shaurjyabanerjee/seamonster/prototyping_pics/panel_wiring_6.jpg

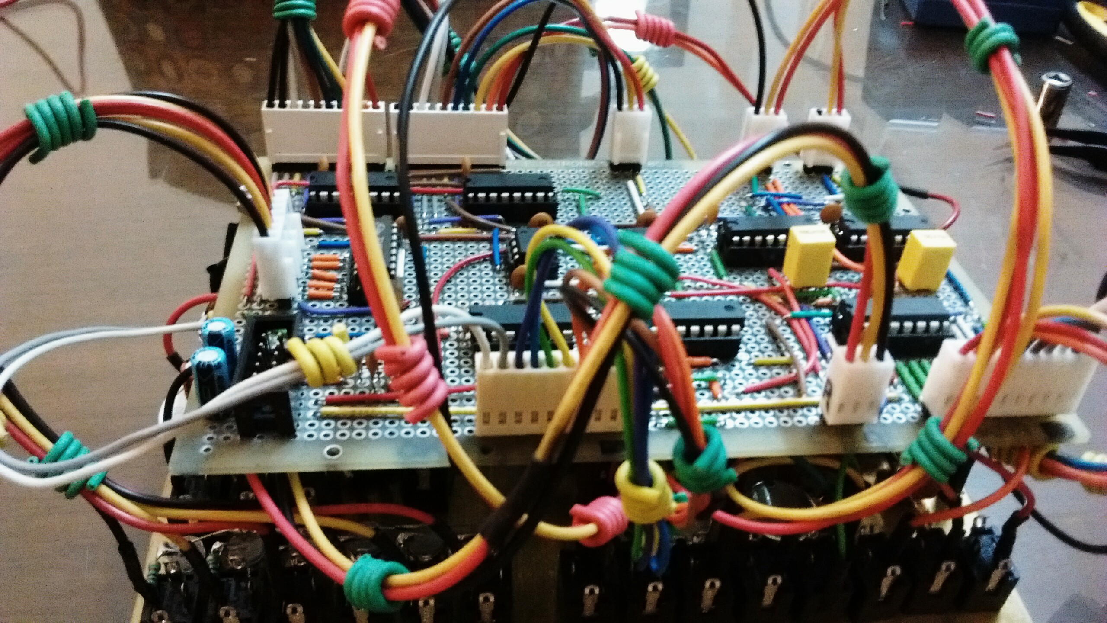
prototyping_pics/panel_wiring_6.jpg
