shaurjyabanerjee/seamonster/prototyping_pics/panel_wiring_5.jpg

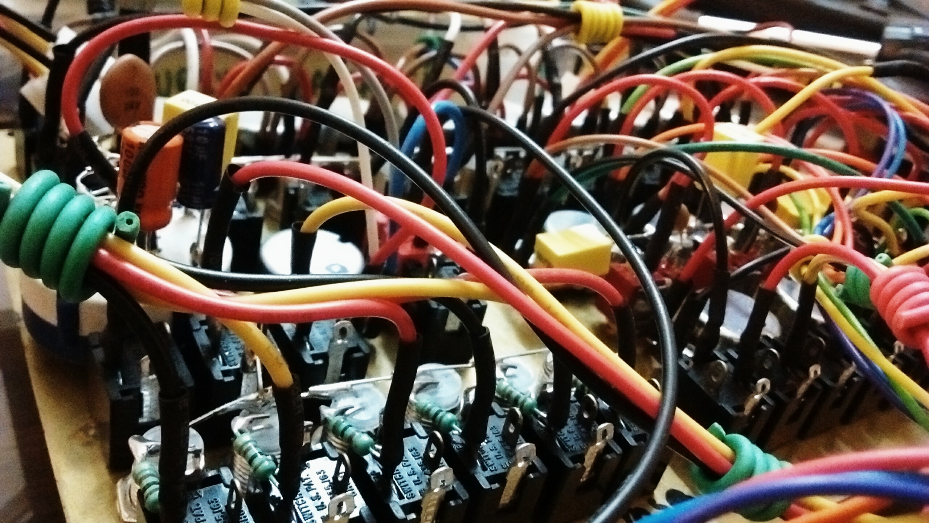
prototyping_pics/panel_wiring_5.jpg
