shaurjyabanerjee/seamonster/pcb_layouts/seamonster_revision_notes.rtf

SeaMonster PCB Revision Notes

• Apply buffering to the output stage of all fixed frequency oscillators
• Add buffering to DG408 MUX output, will allow multing
• Add offset resistors in series to R2 for VCOs
• Add buffering to complex XOR outs
• Make negative voltage clamping circuit for external clock input
• Maybe use left over inverter from 40106 to ‘clean’ external clock
•
