shaurjyabanerjee/seamonster/prototyping_pics/finished_seamonster_1.jpg

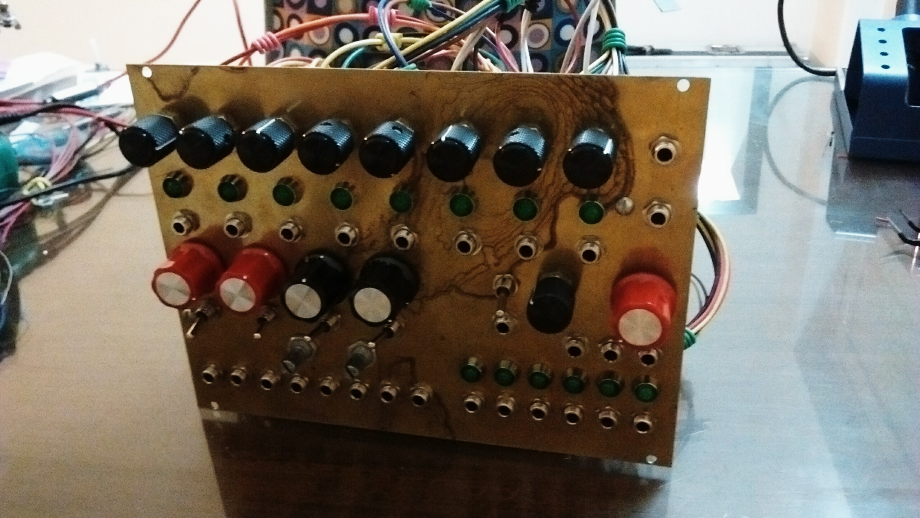
prototyping_pics/finished_seamonster_1.jpg
