shaurjyabanerjee/seamonster/prototyping_pics/finished_seamonster_2.jpg

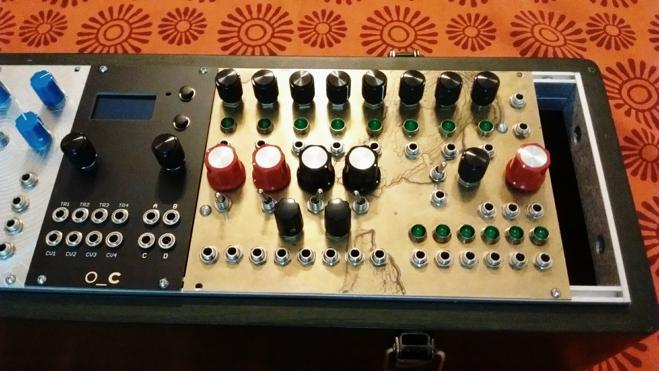
prototyping_pics/finished_seamonster_2.jpg
