shaurjyabanerjee/seamonster/prototyping_pics/finished_seamonster_3.jpg

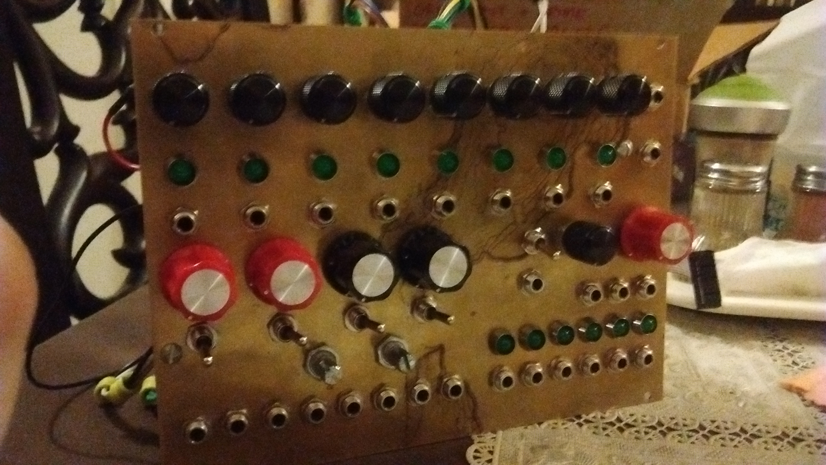
prototyping_pics/finished_seamonster_3.jpg
