shaurjyabanerjee/seamonster/prototyping_pics/full_system.jpg

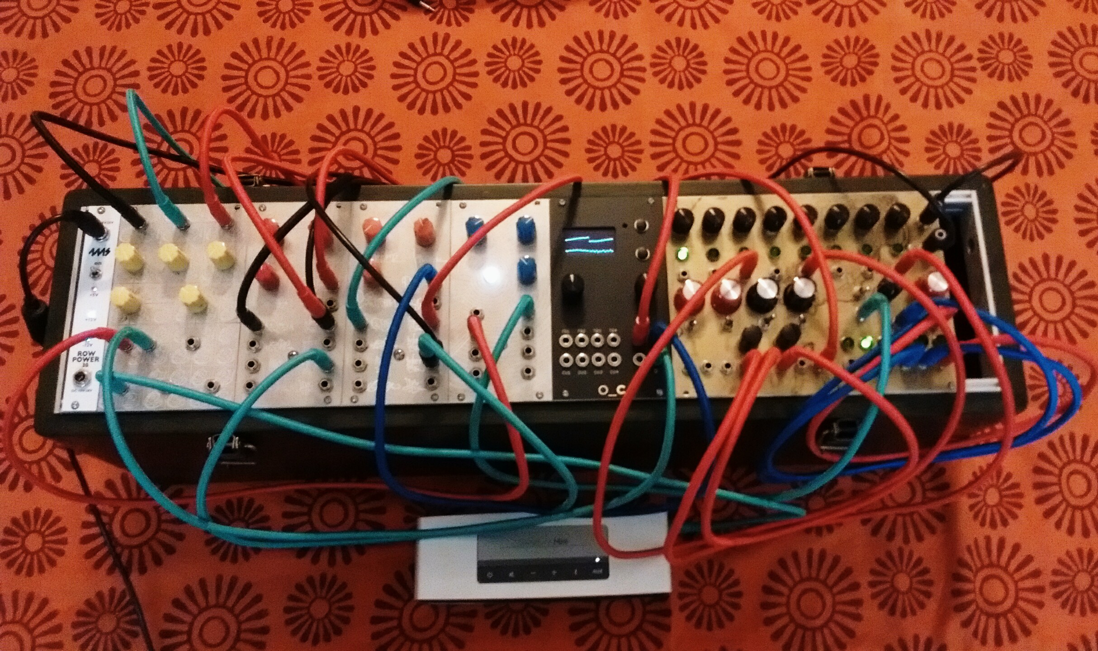
prototyping_pics/full_system.jpg
