shaurjyabanerjee/seamonster/prototyping_pics/panel_drilled.jpg

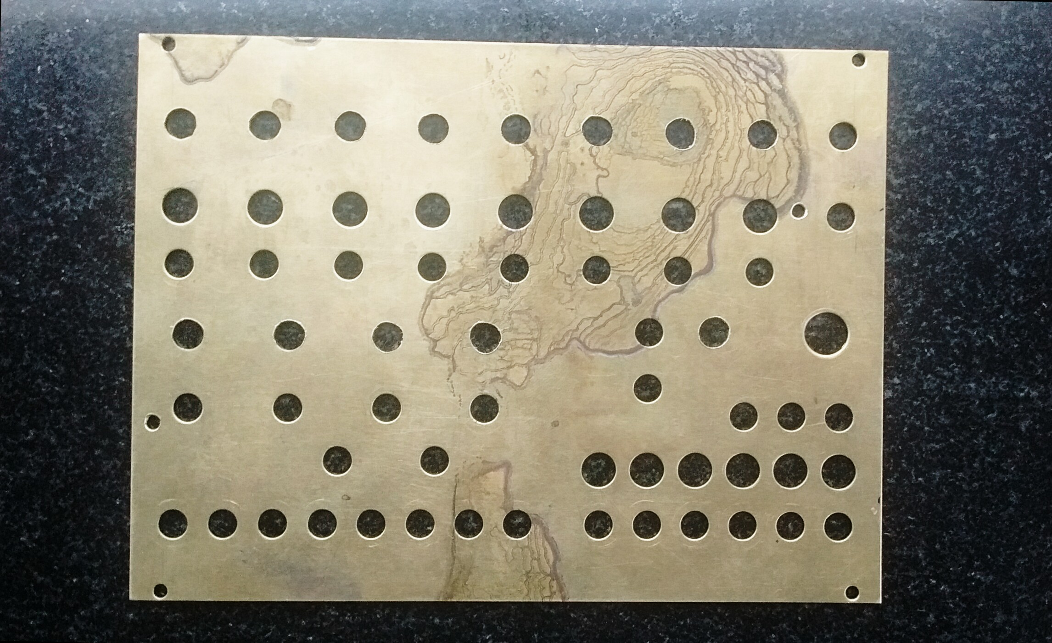
prototyping_pics/panel_drilled.jpg
