shaurjyabanerjee/seamonster/prototyping_pics/panel_fully_wired.jpg

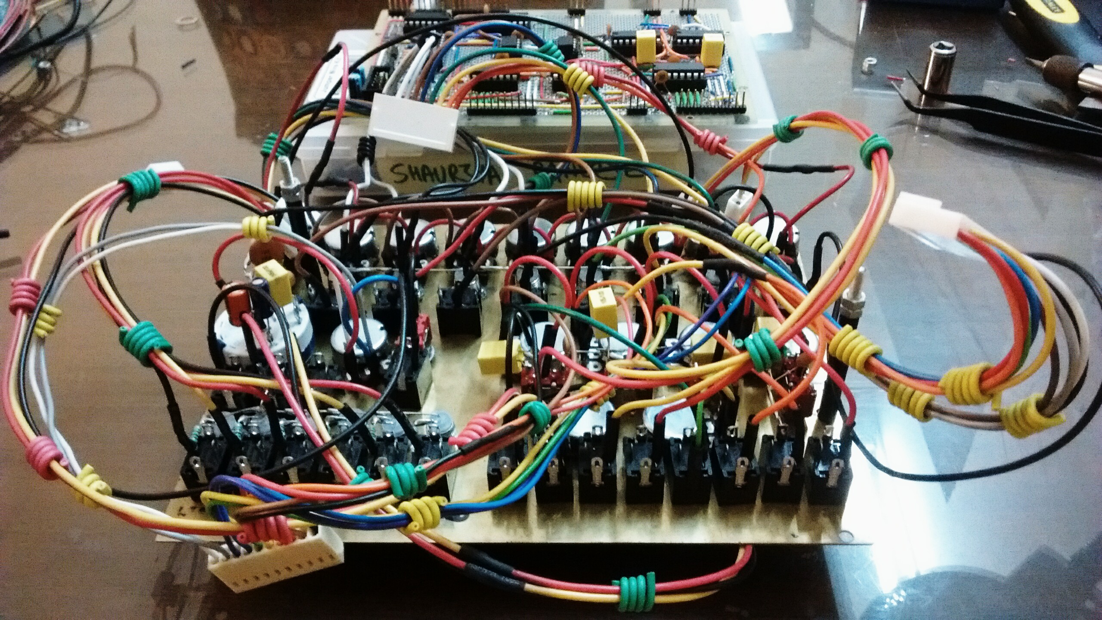
prototyping_pics/panel_fully_wired.jpg
