shaurjyabanerjee/seamonster/prototyping_pics/panel_populated_back.jpg

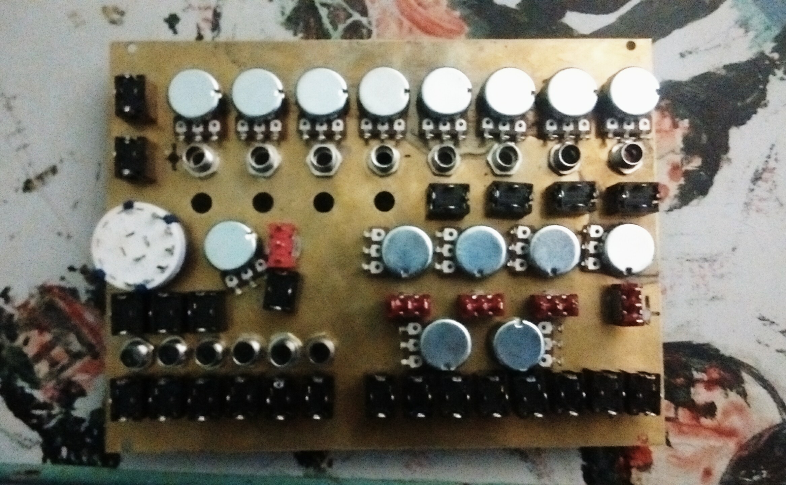
prototyping_pics/panel_populated_back.jpg
