shaurjyabanerjee/seamonster/prototyping_pics/panel_populated_front.jpg

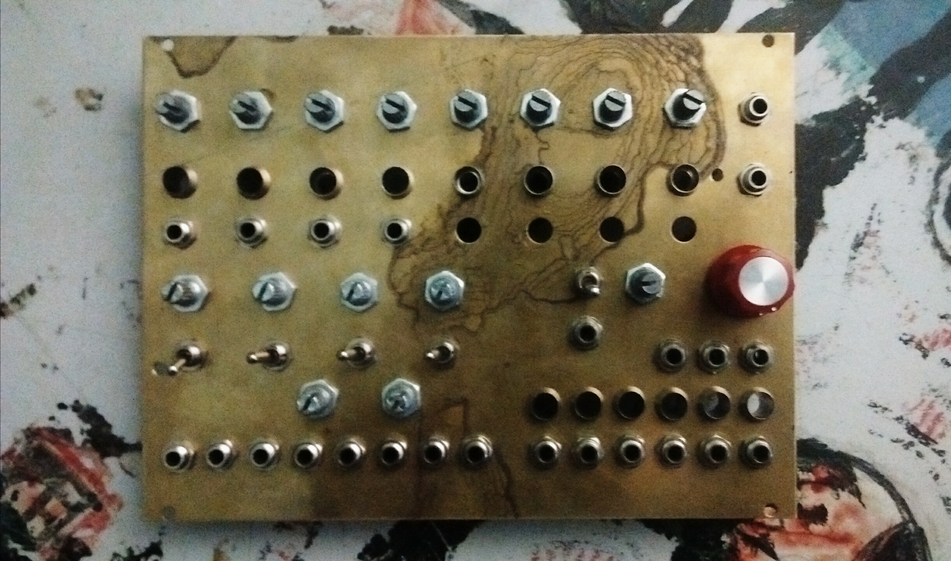
prototyping_pics/panel_populated_front.jpg
