shaurjyabanerjee/seamonster/prototyping_pics/perfboard_1.jpg

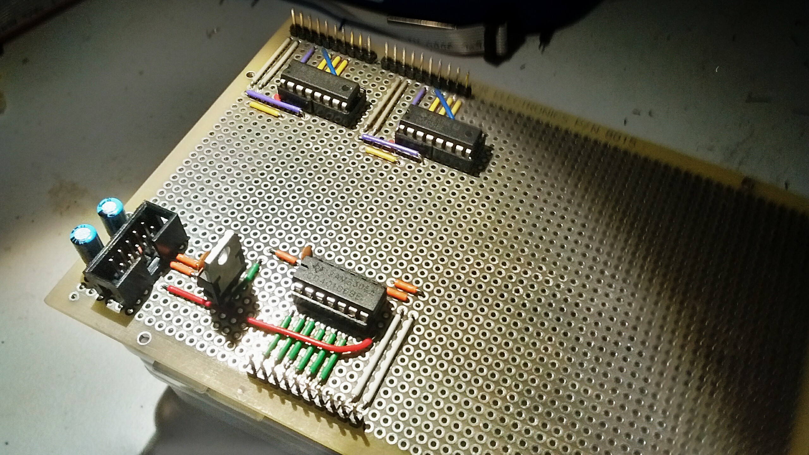
prototyping_pics/perfboard_1.jpg
