shaurjyabanerjee/seamonster/prototyping_pics/perfboard_2.jpg

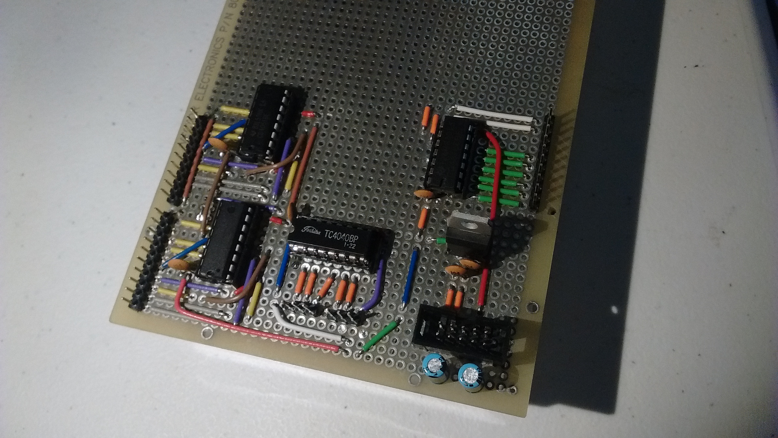
prototyping_pics/perfboard_2.jpg
