shaurjyabanerjee/seamonster/prototyping_pics/perfboard_3.jpg

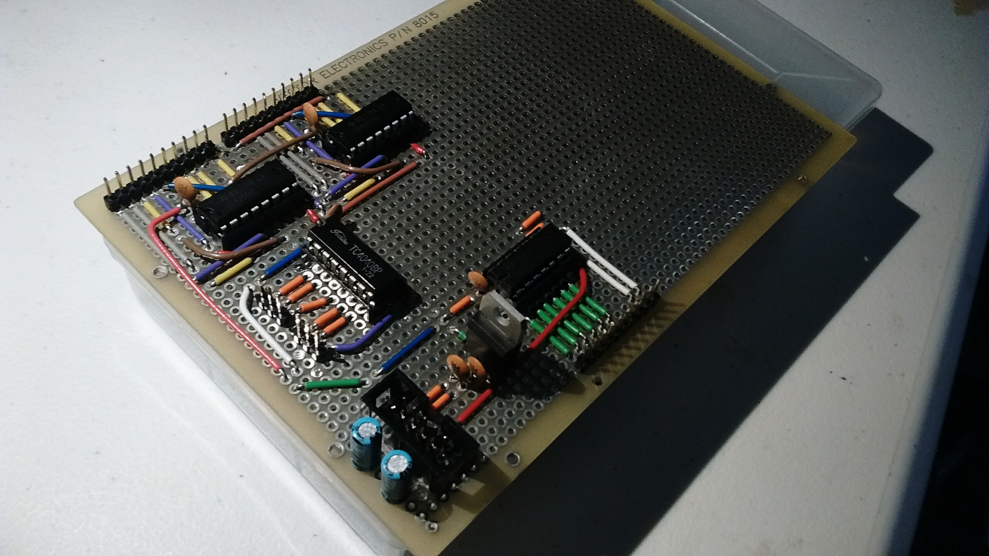
prototyping_pics/perfboard_3.jpg
