shaurjyabanerjee/seamonster/prototyping_pics/perfboard_4.jpg

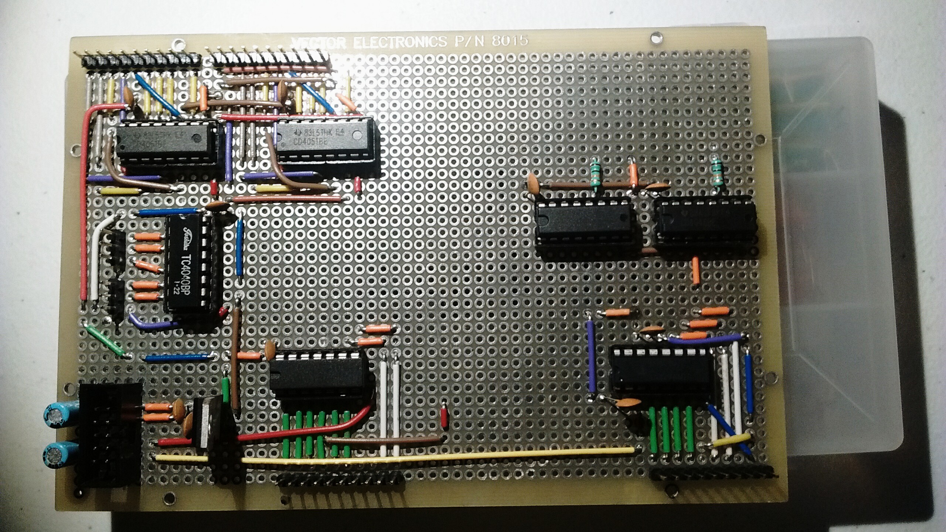
prototyping_pics/perfboard_4.jpg
