shaurjyabanerjee/seamonster/prototyping_pics/perfboard_5.jpg

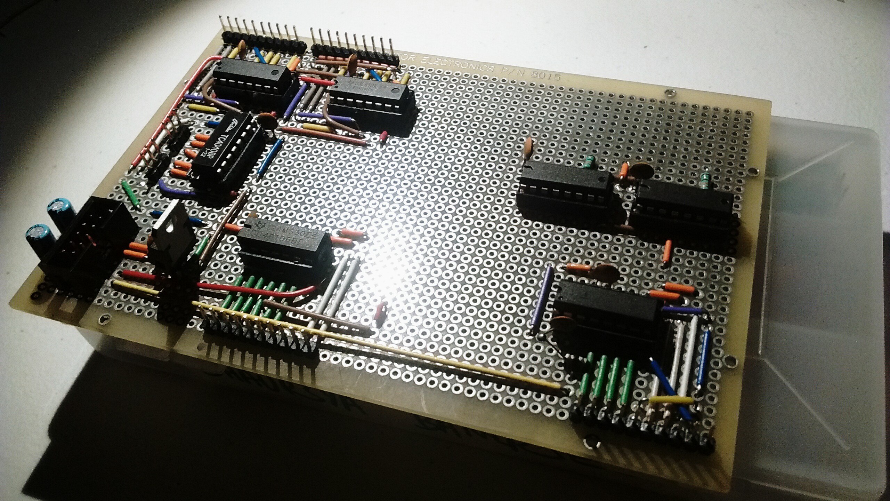
prototyping_pics/perfboard_5.jpg
