shaurjyabanerjee/seamonster/prototyping_pics/perfboard_6.jpg

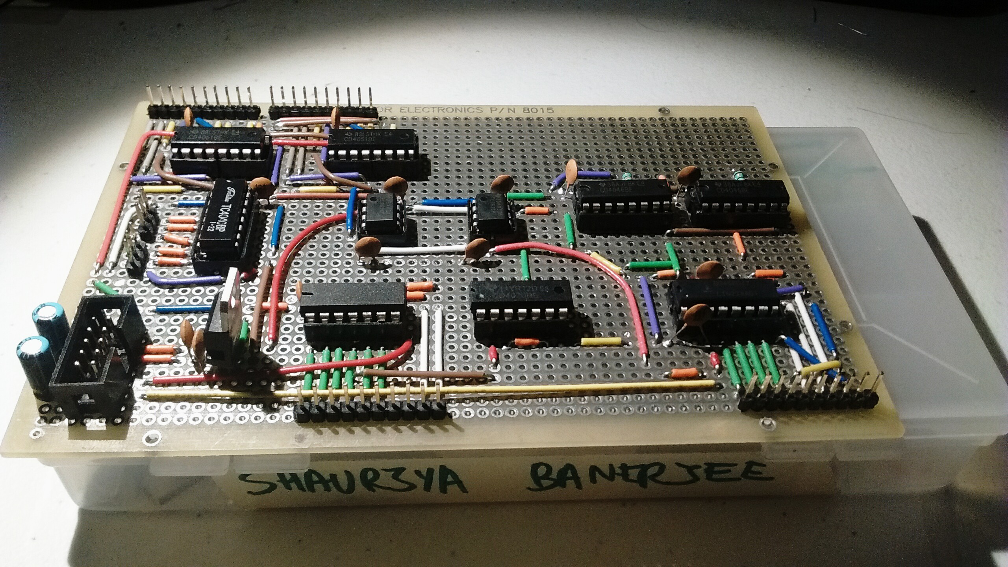
prototyping_pics/perfboard_6.jpg
