shaurjyabanerjee/seamonster/prototyping_pics/perfboard_7.jpg

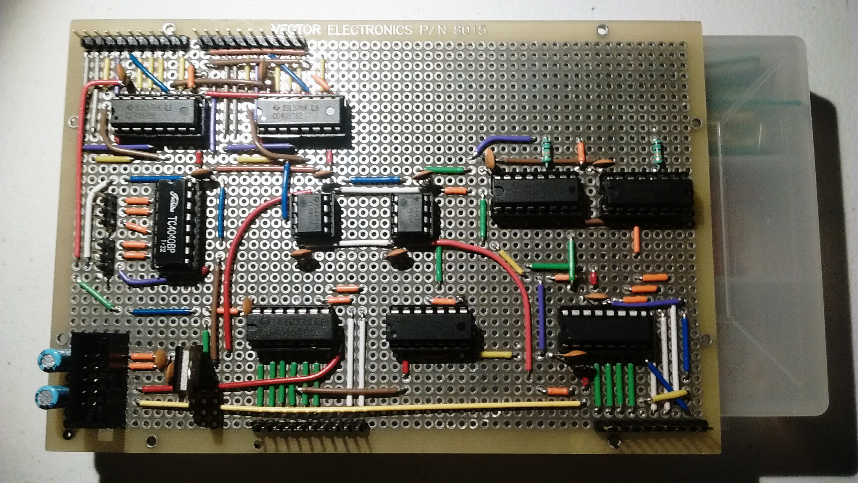
prototyping_pics/perfboard_7.jpg
