shaurjyabanerjee/seamonster/prototyping_pics/perfboard_bottom.jpg

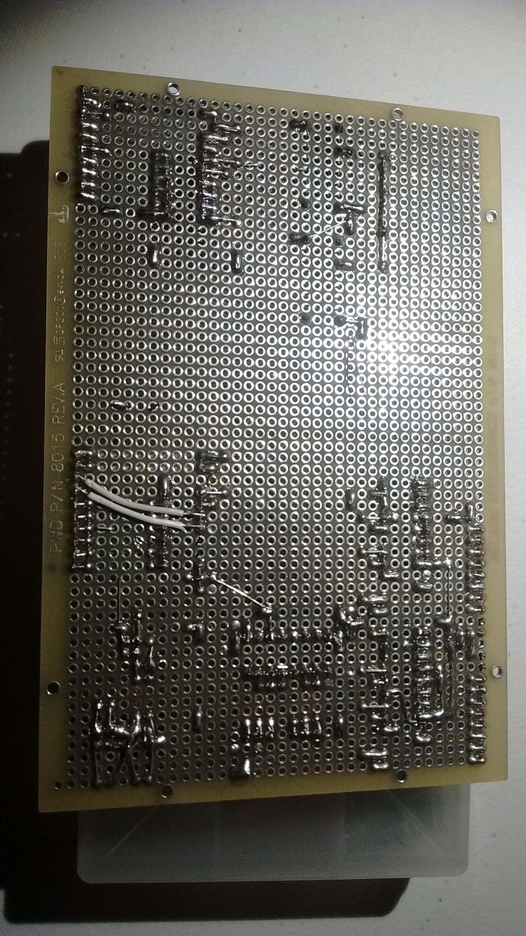
prototyping_pics/perfboard_bottom.jpg
