shaurjyabanerjee/seamonster/prototyping_pics/perfboard_finished_bottom.jpg

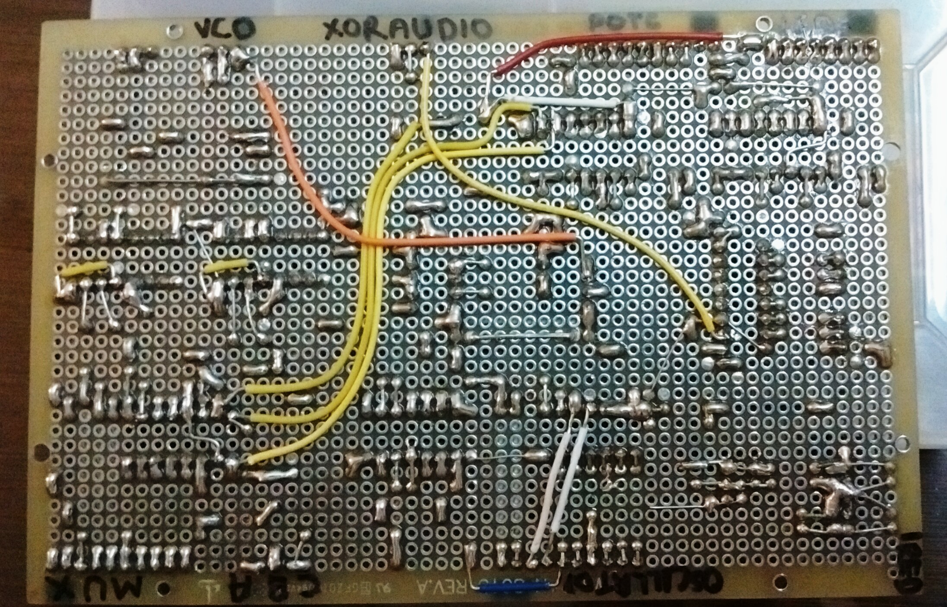
prototyping_pics/perfboard_finished_bottom.jpg
