shaurjyabanerjee/seamonster/prototyping_pics/perfboard_finished_top.jpg

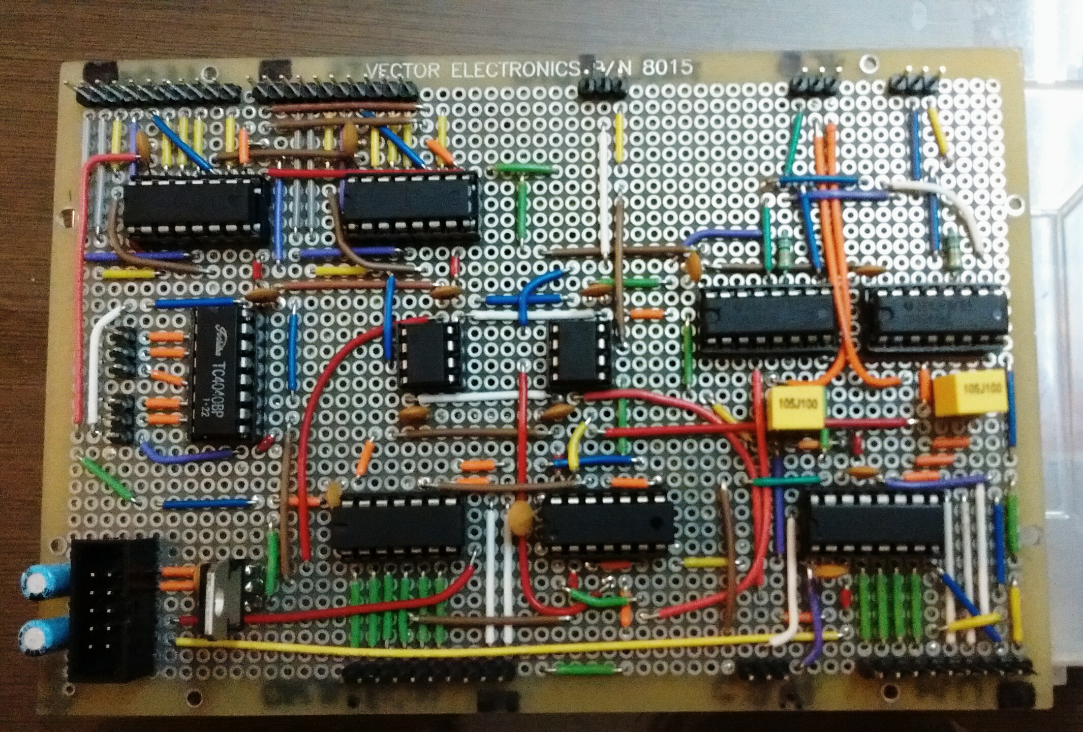
prototyping_pics/perfboard_finished_top.jpg
