shaurjyabanerjee/seamonster/pcb_layouts/panel_layouts/ai_sketches/seamonster_panel_layout/waves_simp_test1.dxf

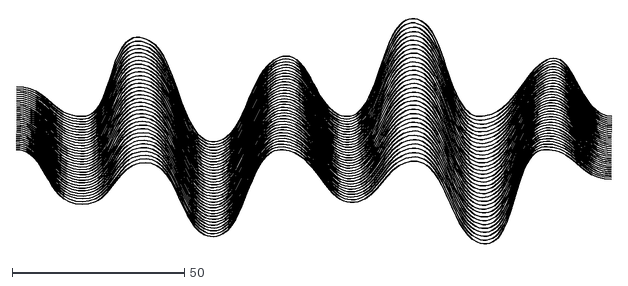
[picture p21: CAD file, 2019-03-12]
pcb_layouts/panel_layouts/ai_sketches/seamonster_panel_layout/waves_simp_test1.dxf
172.6 x 66.7
