shaurjyabanerjee/seamonster/pcb_layouts/panel_layouts/ai_sketches/wave_test1.dxf

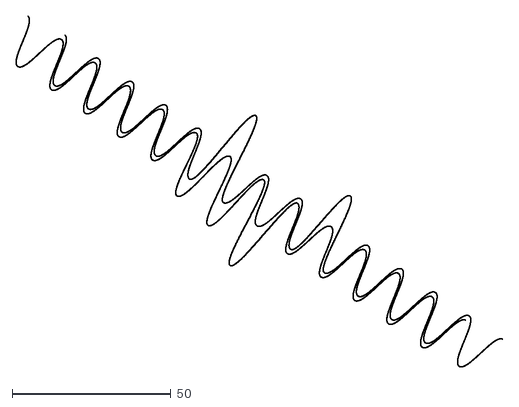
[picture p22: CAD file, 2018-10-15]
pcb_layouts/panel_layouts/ai_sketches/wave_test1.dxf
153.3 x 110.5
