shaurjyabanerjee/seamonster/pcb_layouts/panel_layouts/waves_simp_test1.dxf

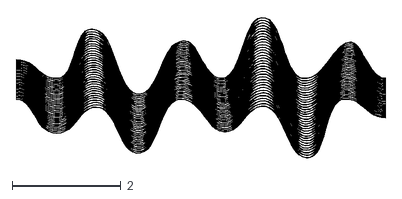
[picture p23: CAD file, 2019-03-12]
pcb_layouts/panel_layouts/waves_simp_test1.dxf
6.80 x 2.63
