shaurjyabanerjee/seamonster/pcb_layouts/panel_layouts/ai_sketches/seamonster_panel_layout/seamonster_panel_layout_2.dxf

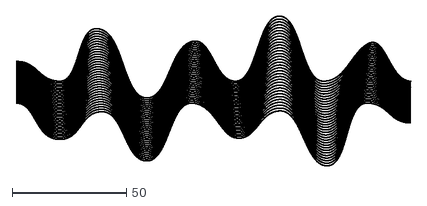
[picture p24: CAD file, 2019-03-12]
pcb_layouts/panel_layouts/ai_sketches/seamonster_panel_layout/seamonster_panel_layout_2.dxf
172.6 x 65.4
