shaurjyabanerjee/seamonster/(list of files, cad)

Other CAD files:
export_files/seamonster_drill.dxf
prototype_panel/seamonster_drill.dwg
export_files/seamonster_drill.dwg
