shaurjyabanerjee/seamonster/prototyping_pics/panel_wiring_1.jpg

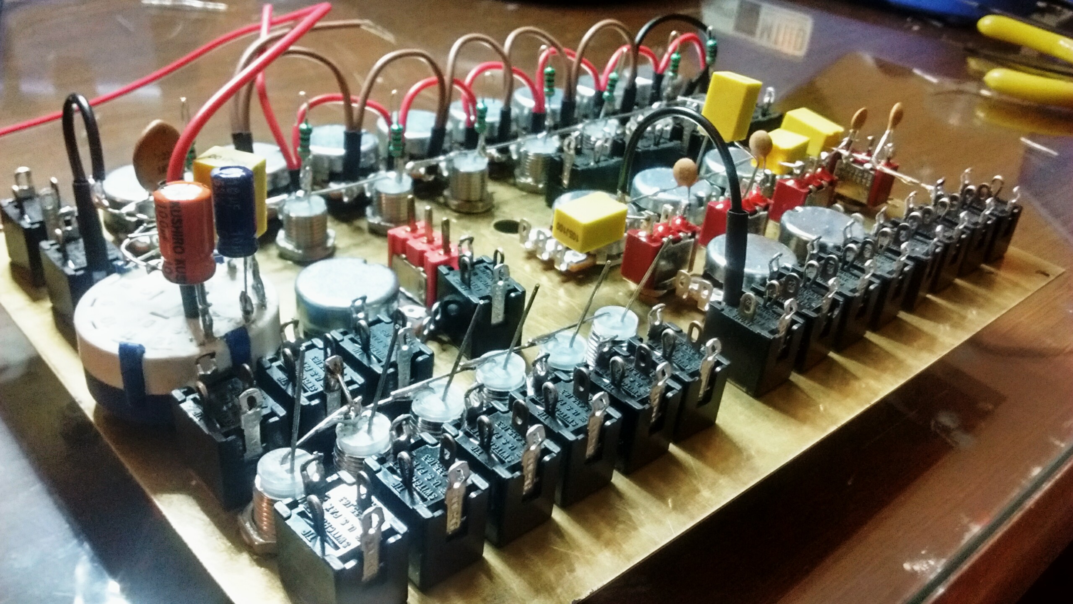
prototyping_pics/panel_wiring_1.jpg
