shaurjyabanerjee/seamonster/prototyping_pics/panel_wiring_2.jpg

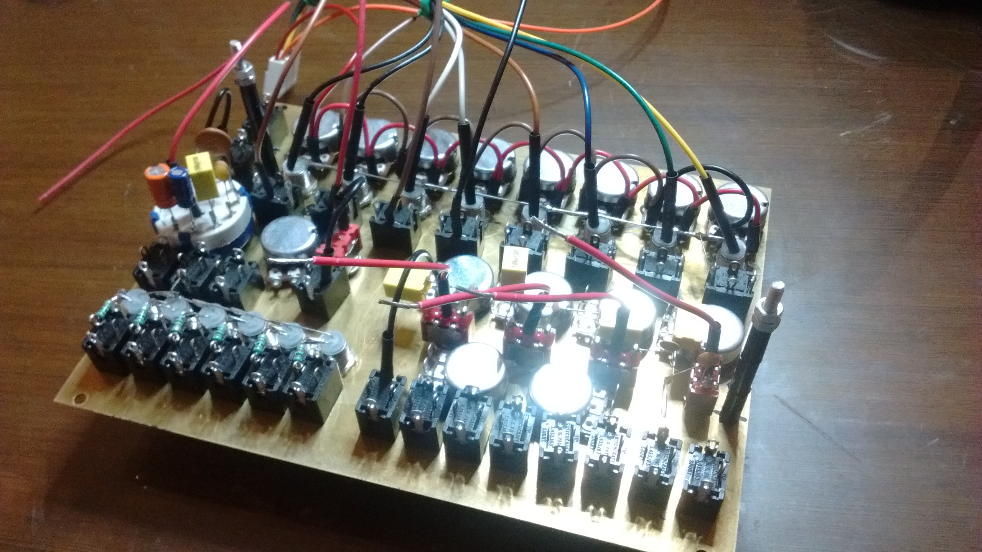
prototyping_pics/panel_wiring_2.jpg
