shaurjyabanerjee/seamonster/prototyping_pics/panel_wiring_3.jpg

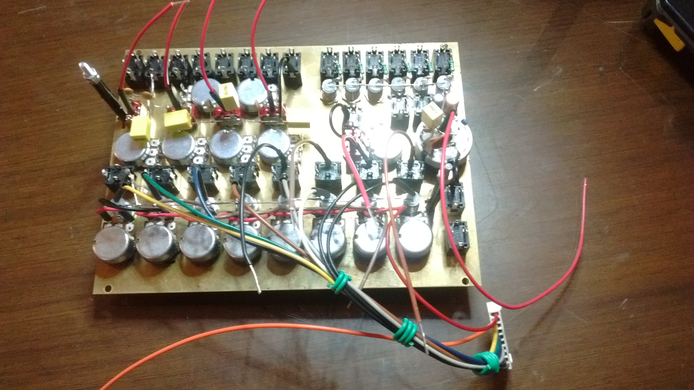
prototyping_pics/panel_wiring_3.jpg
