shaurjyabanerjee/seamonster/prototyping_pics/panel_wiring_4.jpg

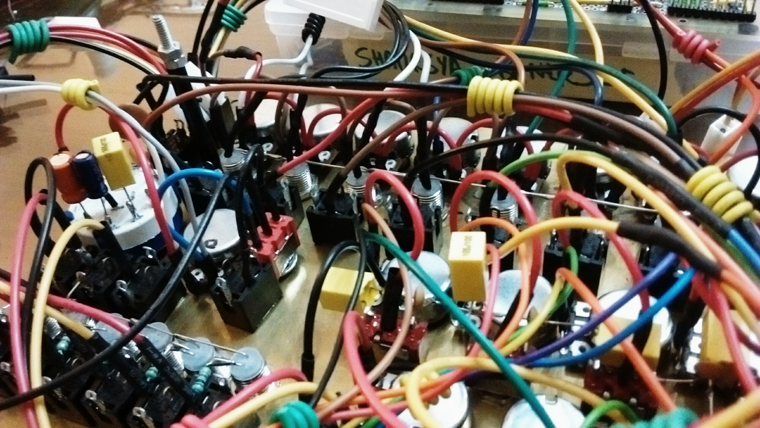
prototyping_pics/panel_wiring_4.jpg
