shaurjyabanerjee/seamonster/export_files/seamonster_drill.pdf

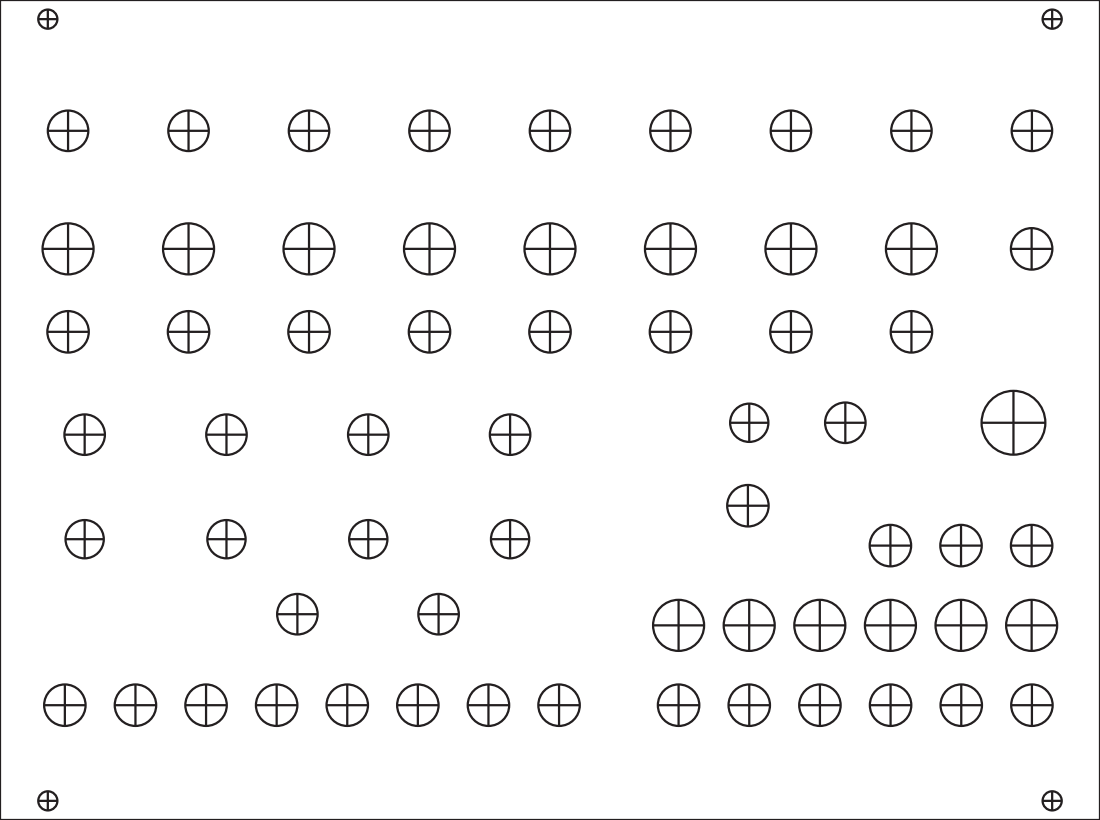
[picture p29: page 1]
