shaurjyabanerjee/seamonster/prototype_panel/seamonster_draft_1.pdf

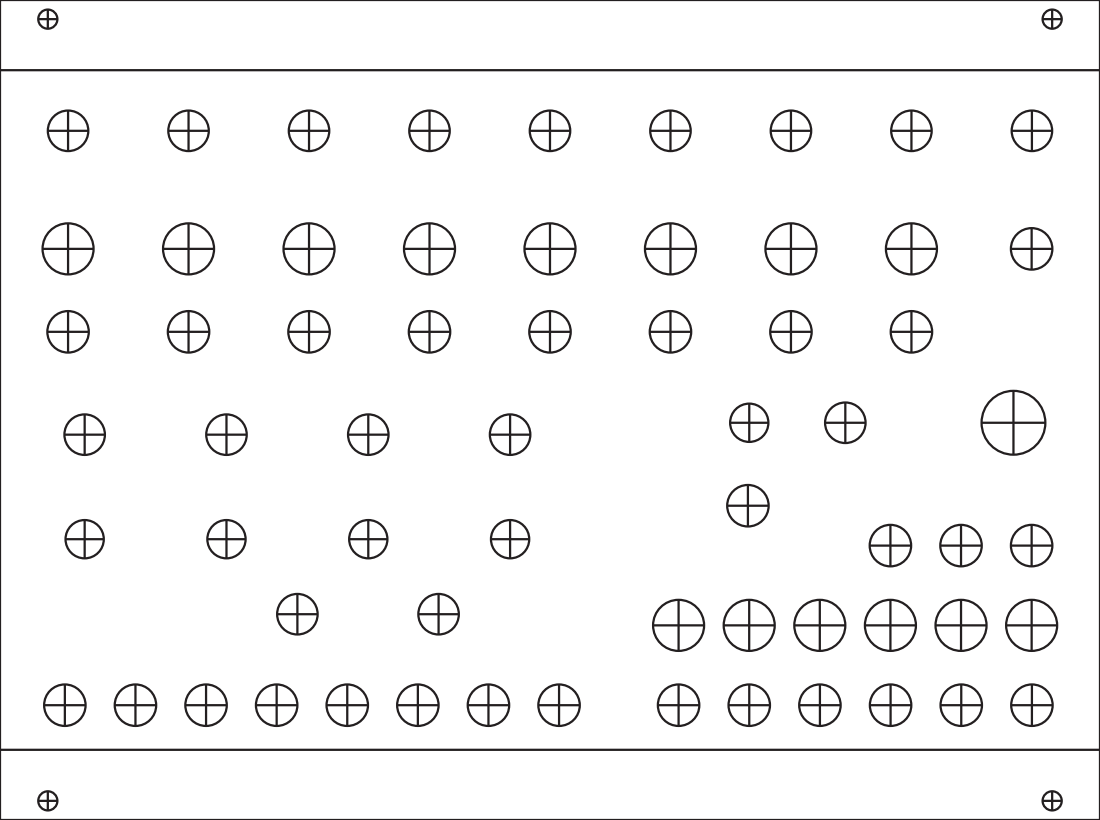
[picture p30: page 1]
