shaurjyabanerjee/seamonster/pcb_layouts/seamonster_smd/seamonster_buffered3.brd

## EAGLE design pcb_layouts/seamonster_smd/seamonster_buffered3.brd (2019-03-12)

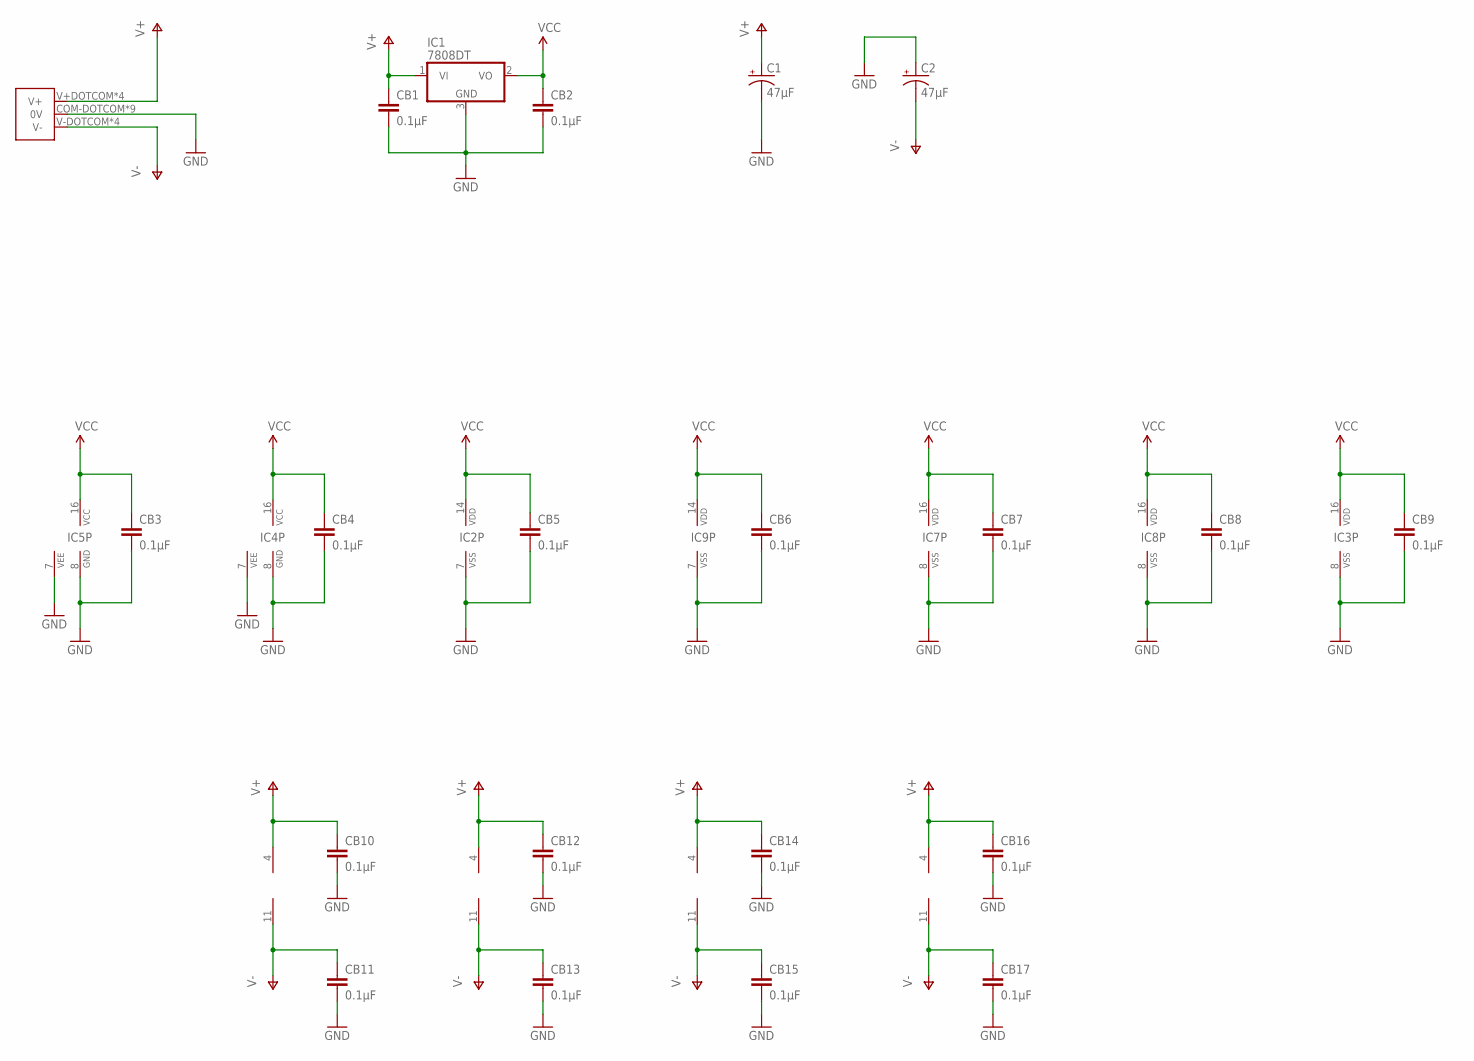
[picture p31: schematic seamonster_buffered3.sch, sheet 1, Power Filtering & Bypass]

Parts:
C1, C2: 47µF; CPOL-RADIAL-10UF-25V
CB1, CB2, CB3, CB4, CB5, CB6, CB7, CB8, CB9, CB10, CB11, CB12, CB13, CB14, CB15, CB16, CB17: 0.1µF; 0805
IC1: 7808DT; TO252
IC2: 40106D; SO14
IC3: 4040D; SO16
IC4, IC5: 4051D; SO16
IC7, IC8: 4046D; SO16
IC9: 4070D; SO14
U1, U2, U3: TL084; SO14
U4: TL084D; SO14
U$1: COMBO_POWER

Connections:
GND: C1.2 (-), C2.1 (+), CB1.2, CB2.2, CB3.2, CB4.2, CB5.2, CB6.2, CB7.2, CB8.2, CB9.2, CB10.2, CB11.2, CB12.2, CB13.2, CB14.2, CB15.2, CB16.2, CB17.2, IC1.3 (GND), IC2.7 (VSS), IC3.8 (VSS), IC4.7 (VEE), IC4.8 (GND), IC5.7 (VEE), IC5.8 (GND), IC7.8 (VSS), IC8.8 (VSS), IC9.7 (VSS), U$1.COM-DOTCOM (0V), U$1.COM-EURO1 (0V), U$1.COM-EURO2 (0V), U$1.COM-EURO3 (0V), U$1.COM-EURO4 (0V), U$1.COM-EURO5 (0V), U$1.COM-EURO6 (0V), U$1.COM-MOTM1 (0V), U$1.COM_MOTM2 (0V); also elsewhere on the board
V+: C1.1 (+), CB1.1, CB10.1, CB12.1, CB14.1, CB16.1, IC1.1 (VI), U1.4 (V+), U2.4 (V+), U3.4 (V+), U4.4 (V+), U$1.V+DOTCOM (V+), U$1.V+EURO1 (V+), U$1.V+EURO2 (V+), U$1.V+MOTM (V+); also elsewhere on the board
V-: C2.2 (-), CB11.1, CB13.1, CB15.1, CB17.1, U1.11 (V-), U2.11 (V-), U3.11 (V-), U4.11 (V-), U$1.V-DOTCOM (V-), U$1.V-EURO1 (V-), U$1.V-EURO2 (V-), U$1.V-MOTM (V-); also elsewhere on the board
VCC: CB2.1, CB3.1, CB4.1, CB5.1, CB6.1, CB7.1, CB8.1, CB9.1, IC1.2 (VO), IC2.14 (VDD), IC3.16 (VDD), IC4.16 (VCC), IC5.16 (VCC), IC7.16 (VDD), IC8.16 (VDD), IC9.14 (VDD); also elsewhere on the board

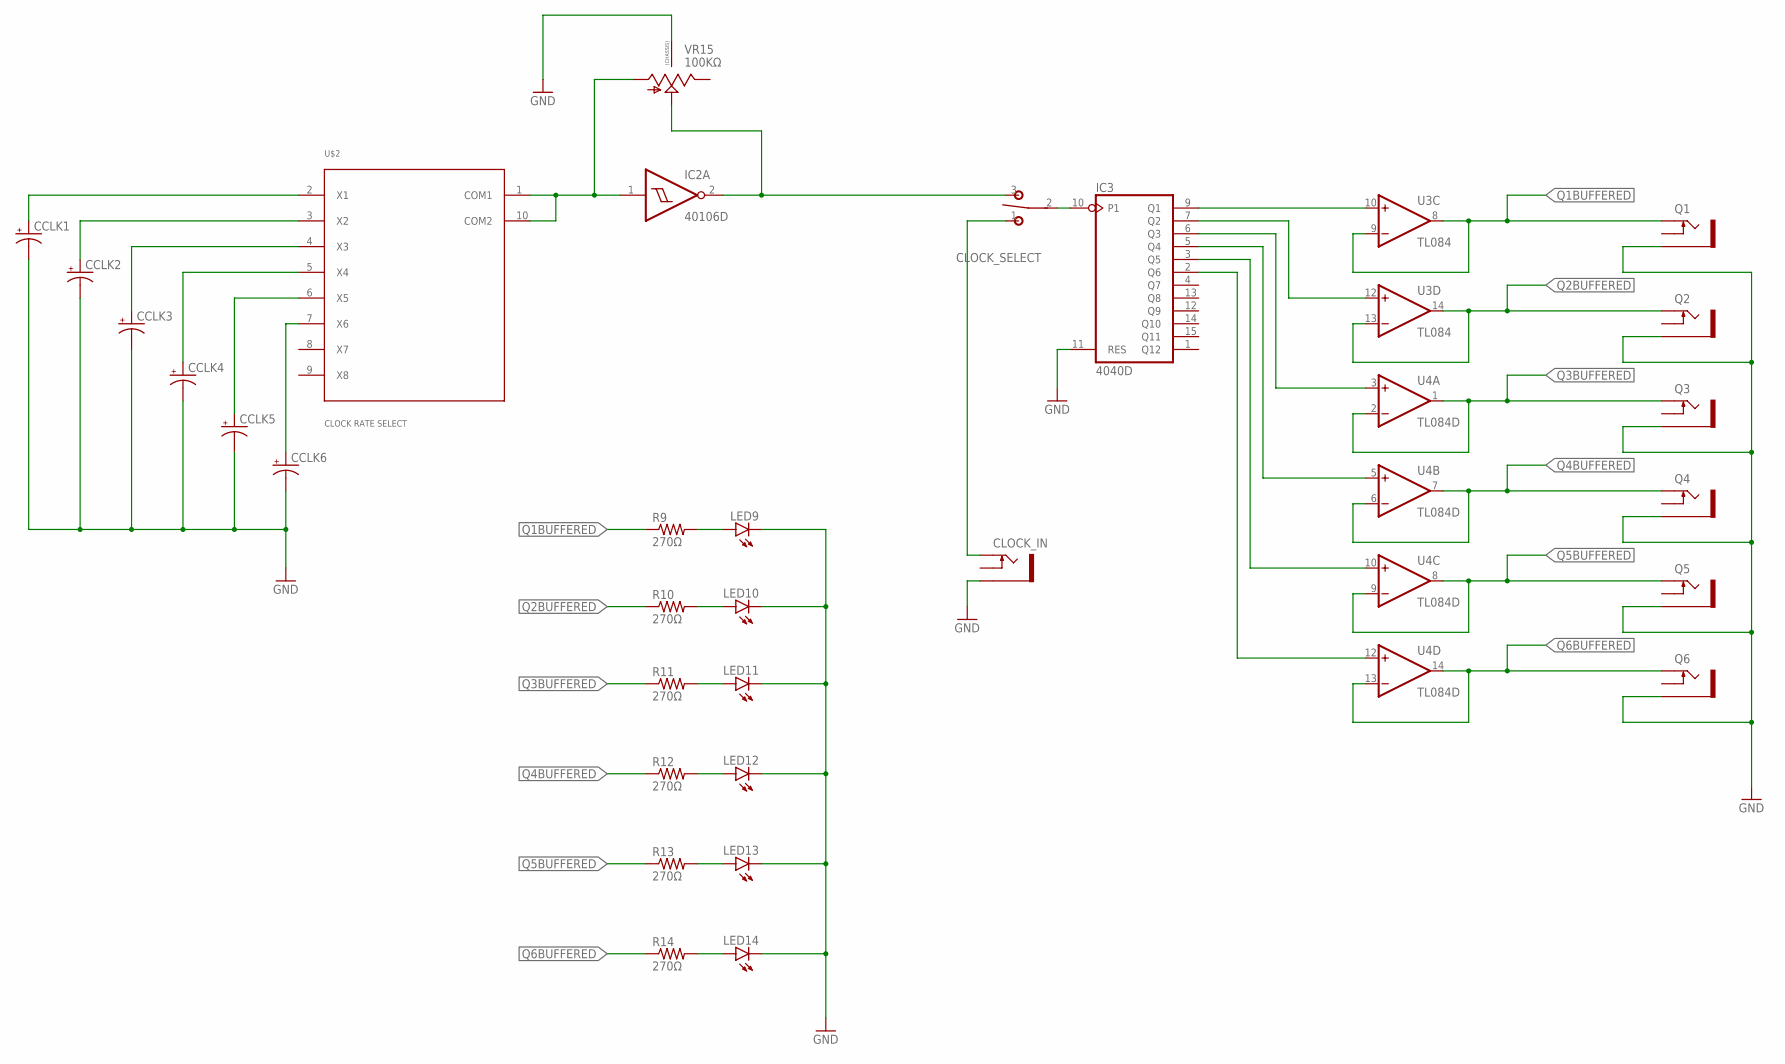
[picture p32: schematic seamonster_buffered3.sch, sheet 2, Clock Oscillator & Divider]

Parts:
CCLK1, CCLK2, CCLK3, CCLK4, CCLK5, CCLK6: 10UF-25V-20%(PTH); CPOL-RADIAL-10UF-25V
CLOCK_IN: THONKICONNNEW; WQP-PJ301M-12_JACK
CLOCK_SELECT: SPDT ON-ON; M9040P
IC2: 40106D; SO14
IC3: 4040D; SO16
LED9, LED10, LED11, LED12, LED13, LED14: LED3MM
Q1, Q2, Q3, Q4, Q5, Q6: THONKICONNNEW; WQP-PJ301M-12_JACK
R9, R10, R11, R12, R13, R14: 270Ω; 0805
U3: TL084; SO14
U4: TL084D; SO14
U$2: CLOCK RATE SELECT; ALPHA_SR1712F
VR15: 100KΩ; 9MM_SNAP-IN_POT

Connections:
GND: CCLK1.2 (-), CCLK2.2 (-), CCLK3.2 (-), CCLK4.2 (-), CCLK5.2 (-), CCLK6.2 (-), CLOCK_IN.P$3_SLEEVE (SLEEVE), IC3.11 (RES), LED9.K (C), LED10.K (C), LED11.K (C), LED12.K (C), LED13.K (C), LED14.K (C), Q1.P$3_SLEEVE (SLEEVE), Q2.P$3_SLEEVE (SLEEVE), Q3.P$3_SLEEVE (SLEEVE), Q4.P$3_SLEEVE (SLEEVE), Q5.P$3_SLEEVE (SLEEVE), Q6.P$3_SLEEVE (SLEEVE), VR15.CHASSIS2; also elsewhere on the board
unnamed: IC2.1 (I), U$2.1 (COM1), U$2.10 (COM2), VR15.1 (A)
unnamed: CCLK1.1 (+), U$2.2 (X1)
unnamed: CCLK2.1 (+), U$2.3 (X2)
unnamed: CCLK3.1 (+), U$2.4 (X3)
unnamed: CCLK4.1 (+), U$2.5 (X4)
unnamed: CCLK5.1 (+), U$2.6 (X5)
unnamed: CCLK6.1 (+), U$2.7 (X6)
unnamed: CLOCK_SELECT.3 (S), IC2.2 (O), VR15.2 (S)
unnamed: CLOCK_SELECT.2, IC3.10 (P1)
unnamed: LED9.A, R9.2
unnamed: IC3.9 (Q1), U3.10 (+IN)
unnamed: LED10.A, R10.2
unnamed: LED11.A, R11.2
unnamed: LED12.A, R12.2
unnamed: LED13.A, R13.2
unnamed: LED14.A, R14.2
unnamed: CLOCK_IN.P$1_TIP (TIP), CLOCK_SELECT.1 (O)
Q1BUFFERED: Q1.P$1_TIP (TIP), R9.1, U3.8 (OUT), U3.9 (-IN); also elsewhere on the board
Q2: IC3.7 (Q2), U3.12 (+IN)
Q2BUFFERED: Q2.P$1_TIP (TIP), R10.1, U3.13 (-IN), U3.14 (OUT); also elsewhere on the board
Q3: IC3.6 (Q3), U4.3 (+IN)
Q3BUFFERED: Q3.P$1_TIP (TIP), R11.1, U4.1 (OUT), U4.2 (-IN); also elsewhere on the board
Q4: IC3.5 (Q4), U4.5 (+IN)
Q4BUFFERED: Q4.P$1_TIP (TIP), R12.1, U4.6 (-IN), U4.7 (OUT)
Q5: IC3.3 (Q5), U4.10 (+IN)
Q5BUFFERED: Q5.P$1_TIP (TIP), R13.1, U4.8 (OUT), U4.9 (-IN)
Q6: IC3.2 (Q6), U4.12 (+IN)
Q6BUFFERED: Q6.P$1_TIP (TIP), R14.1, U4.13 (-IN), U4.14 (OUT)

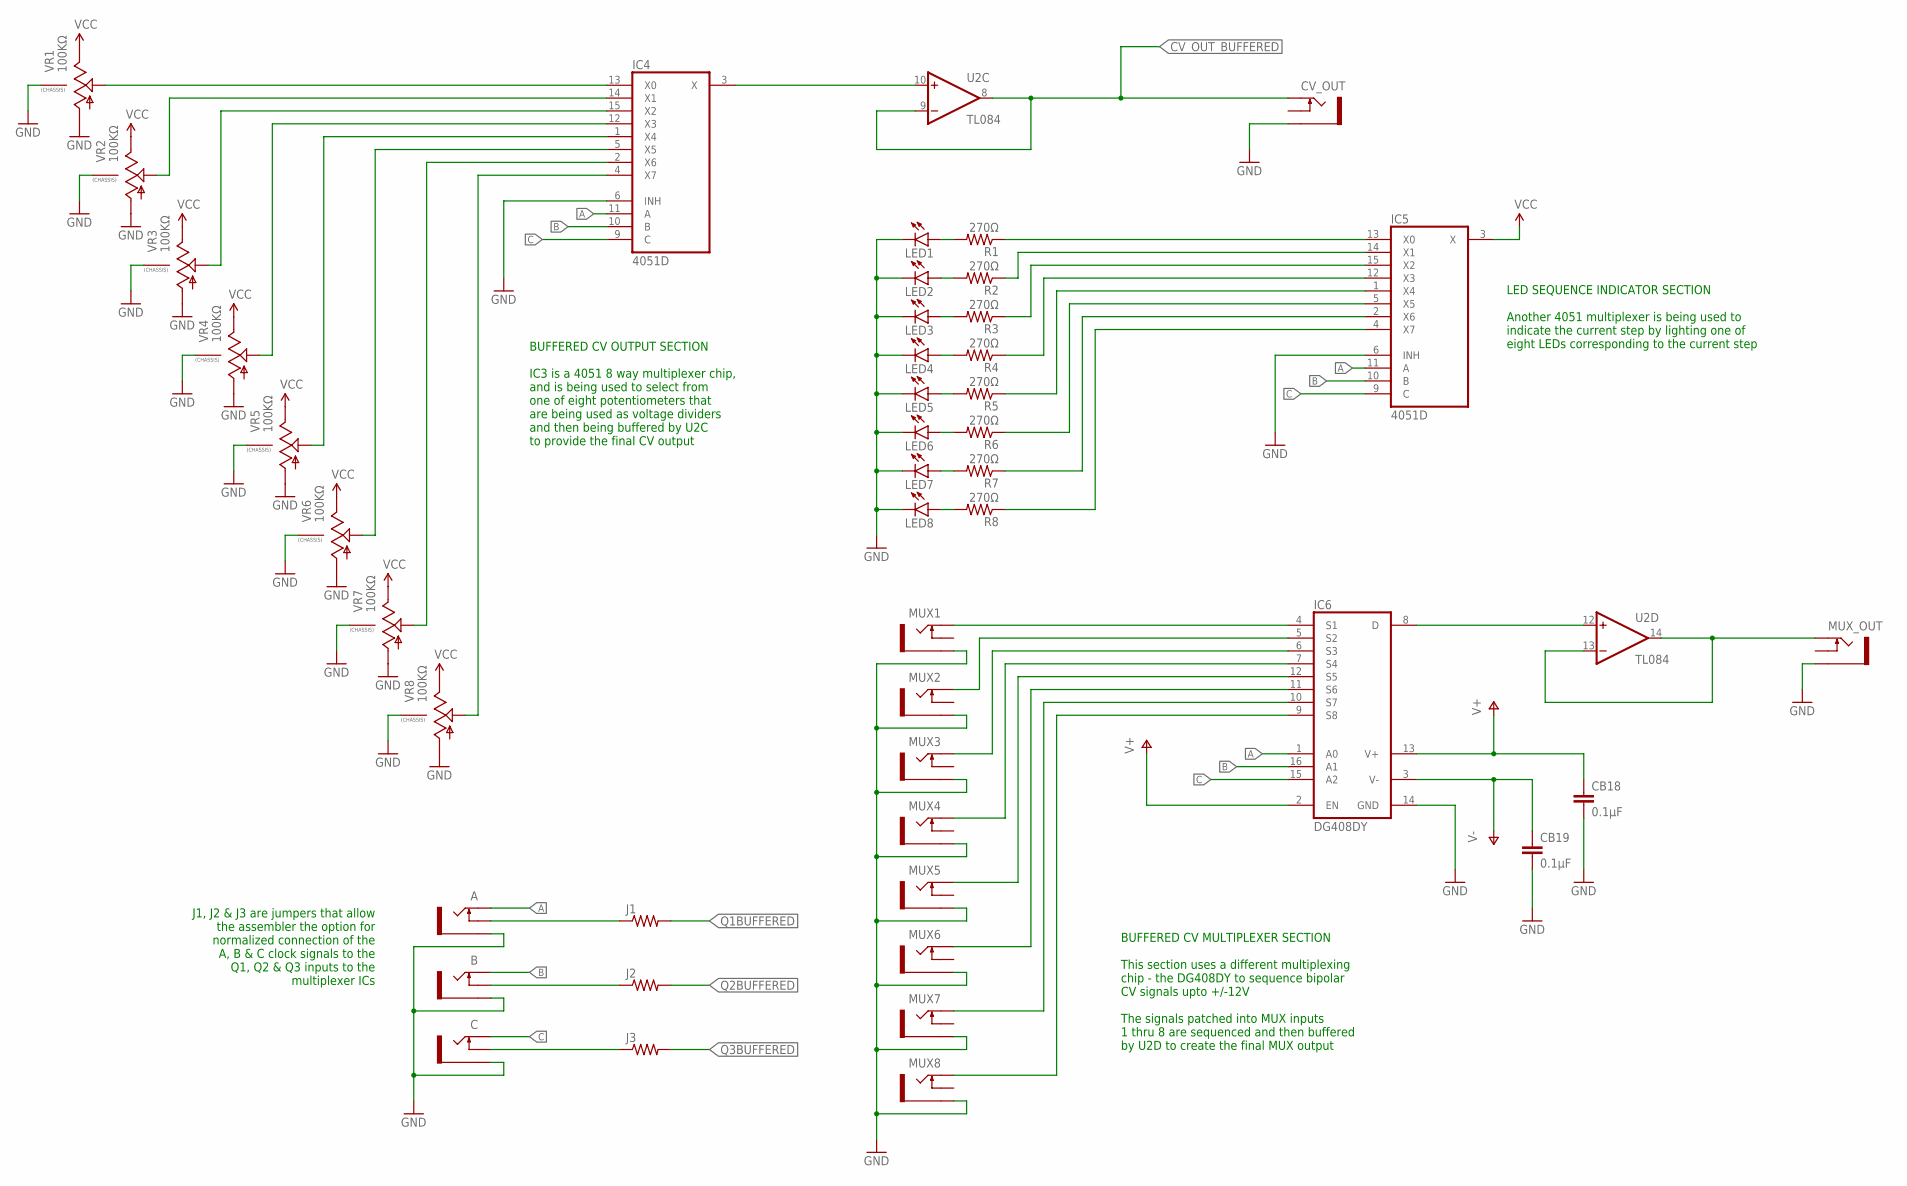
[picture p33: schematic seamonster_buffered3.sch, sheet 3, Multiplexing]

Parts:
A: THONKICONNNEW; WQP-PJ301M-12_JACK
B: THONKICONNNEW; WQP-PJ301M-12_JACK
C: THONKICONNNEW; WQP-PJ301M-12_JACK
CB18, CB19: 0.1µF; 0805
CV_OUT: THONKICONNNEW; WQP-PJ301M-12_JACK
IC4, IC5: 4051D; SO16
IC6: DG408DY; SO16
J1, J2, J3: RESISTOR0805-RES; 0805
LED1, LED2, LED3, LED4, LED5, LED6, LED7, LED8: LED3MM
MUX1, MUX2, MUX3, MUX4, MUX5, MUX6, MUX7, MUX8: THONKICONNNEW; WQP-PJ301M-12_JACK
MUX_OUT: THONKICONNNEW; WQP-PJ301M-12_JACK
R1, R2, R3, R4, R5, R6, R7, R8: 270Ω; 0805
U2: TL084; SO14
VR1, VR2, VR3, VR4, VR5, VR6, VR7, VR8: 100KΩ; 9MM_SNAP-IN_POT

Connections:
A: A.P$1_TIP (TIP), IC4.11 (A), IC5.11 (A), IC6.1 (A0)
B: B.P$1_TIP (TIP), IC4.10 (B), IC5.10 (B), IC6.16 (A1)
C: C.P$1_TIP (TIP), IC4.9 (C), IC5.9 (C), IC6.15 (A2)
CV_OUT: IC4.3 (X), U2.10 (+IN)
CV_OUT_BUFFERED: CV_OUT.P$1_TIP (TIP), U2.8 (OUT), U2.9 (-IN); also elsewhere on the board
GND: A.P$3_SLEEVE (SLEEVE), B.P$3_SLEEVE (SLEEVE), C.P$3_SLEEVE (SLEEVE), CB18.2, CB19.2, CV_OUT.P$3_SLEEVE (SLEEVE), IC4.6 (INH), IC5.6 (INH), IC6.14 (GND), LED1.K (C), LED2.K (C), LED3.K (C), LED4.K (C), LED5.K (C), LED6.K (C), LED7.K (C), LED8.K (C), MUX1.P$3_SLEEVE (SLEEVE), MUX2.P$3_SLEEVE (SLEEVE), MUX3.P$3_SLEEVE (SLEEVE), MUX4.P$3_SLEEVE (SLEEVE), MUX5.P$3_SLEEVE (SLEEVE), MUX6.P$3_SLEEVE (SLEEVE), MUX7.P$3_SLEEVE (SLEEVE), MUX8.P$3_SLEEVE (SLEEVE), MUX_OUT.P$3_SLEEVE (SLEEVE), VR1.1 (A), VR1.CHASSIS2, VR2.1 (A), VR2.CHASSIS2, VR3.1 (A), VR3.CHASSIS2, VR4.1 (A), VR4.CHASSIS2, VR5.1 (A), VR5.CHASSIS2, VR6.1 (A), VR6.CHASSIS2, VR7.1 (A), VR7.CHASSIS2, VR8.1 (A), VR8.CHASSIS2; also elsewhere on the board
MUX1: IC6.4 (S1), MUX1.P$1_TIP (TIP)
MUX2: IC6.5 (S2), MUX2.P$1_TIP (TIP)
MUX3: IC6.6 (S3), MUX3.P$1_TIP (TIP)
MUX4: IC6.7 (S4), MUX4.P$1_TIP (TIP)
MUX5: IC6.12 (S5), MUX5.P$1_TIP (TIP)
MUX6: IC6.11 (S6), MUX6.P$1_TIP (TIP)
MUX7: IC6.10 (S7), MUX7.P$1_TIP (TIP)
MUX8: IC6.9 (S8), MUX8.P$1_TIP (TIP)
unnamed: IC6.8 (D), U2.12 (+IN)
unnamed: MUX_OUT.P$1_TIP (TIP), U2.13 (-IN), U2.14 (OUT)
unnamed: LED1.A, R1.2
unnamed: LED2.A, R2.2
unnamed: LED3.A, R3.2
unnamed: LED4.A, R4.2
unnamed: LED5.A, R5.2
unnamed: LED6.A, R6.2
unnamed: LED7.A, R7.2
unnamed: LED8.A, R8.2
unnamed: IC4.13 (X0), VR1.2 (S)
unnamed: IC5.13 (X0), R1.1
unnamed: IC5.14 (X1), R2.1
unnamed: IC5.15 (X2), R3.1
unnamed: IC5.12 (X3), R4.1
unnamed: IC5.1 (X4), R5.1
unnamed: IC5.5 (X5), R6.1
unnamed: IC5.2 (X6), R7.1
unnamed: IC5.4 (X7), R8.1
unnamed: IC4.14 (X1), VR2.2 (S)
unnamed: IC4.15 (X2), VR3.2 (S)
unnamed: IC4.12 (X3), VR4.2 (S)
unnamed: IC4.1 (X4), VR5.2 (S)
unnamed: IC4.5 (X5), VR6.2 (S)
unnamed: IC4.2 (X6), VR7.2 (S)
unnamed: IC4.4 (X7), VR8.2 (S)
unnamed: A.P$2_SWITCH (SWITCH), J1.1
unnamed: B.P$2_SWITCH (SWITCH), J2.1
unnamed: C.P$2_SWITCH (SWITCH), J3.1
Q1BUFFERED: J1.2; also elsewhere on the board
Q2BUFFERED: J2.2; also elsewhere on the board
Q3BUFFERED: J3.2; also elsewhere on the board
V+: CB18.1, IC6.2 (EN), IC6.13 (V+); also elsewhere on the board
V-: CB19.1, IC6.3 (V-); also elsewhere on the board
VCC: IC5.3 (X), VR1.3 (E), VR2.3 (E), VR3.3 (E), VR4.3 (E), VR5.3 (E), VR6.3 (E), VR7.3 (E), VR8.3 (E); also elsewhere on the board

Notes on the sheet:
LED SEQUENCE INDICATOR SECTION Another 4051 multiplexer is being used to indicate the current step by lighting one of eight LEDs corresponding to the current step
J1, J2 & J3 are jumpers that allow the assembler the option for normalized connection of the A, B & C clock signals to the Q1, Q2 & Q3 inputs to the multiplexer ICs
BUFFERED CV OUTPUT SECTION IC3 is a 4051 8 way multiplexer chip, and is being used to select from one of eight potentiometers that are being used as voltage dividers and then being buffered by U2C to provide the final CV output
BUFFERED CV MULTIPLEXER SECTION This section uses a different multiplexing chip - the DG408DY to sequence bipolar CV signals upto +/-12V The signals patched into MUX inputs 1 thru 8 are sequenced and then buffered by U2D to create the final MUX output

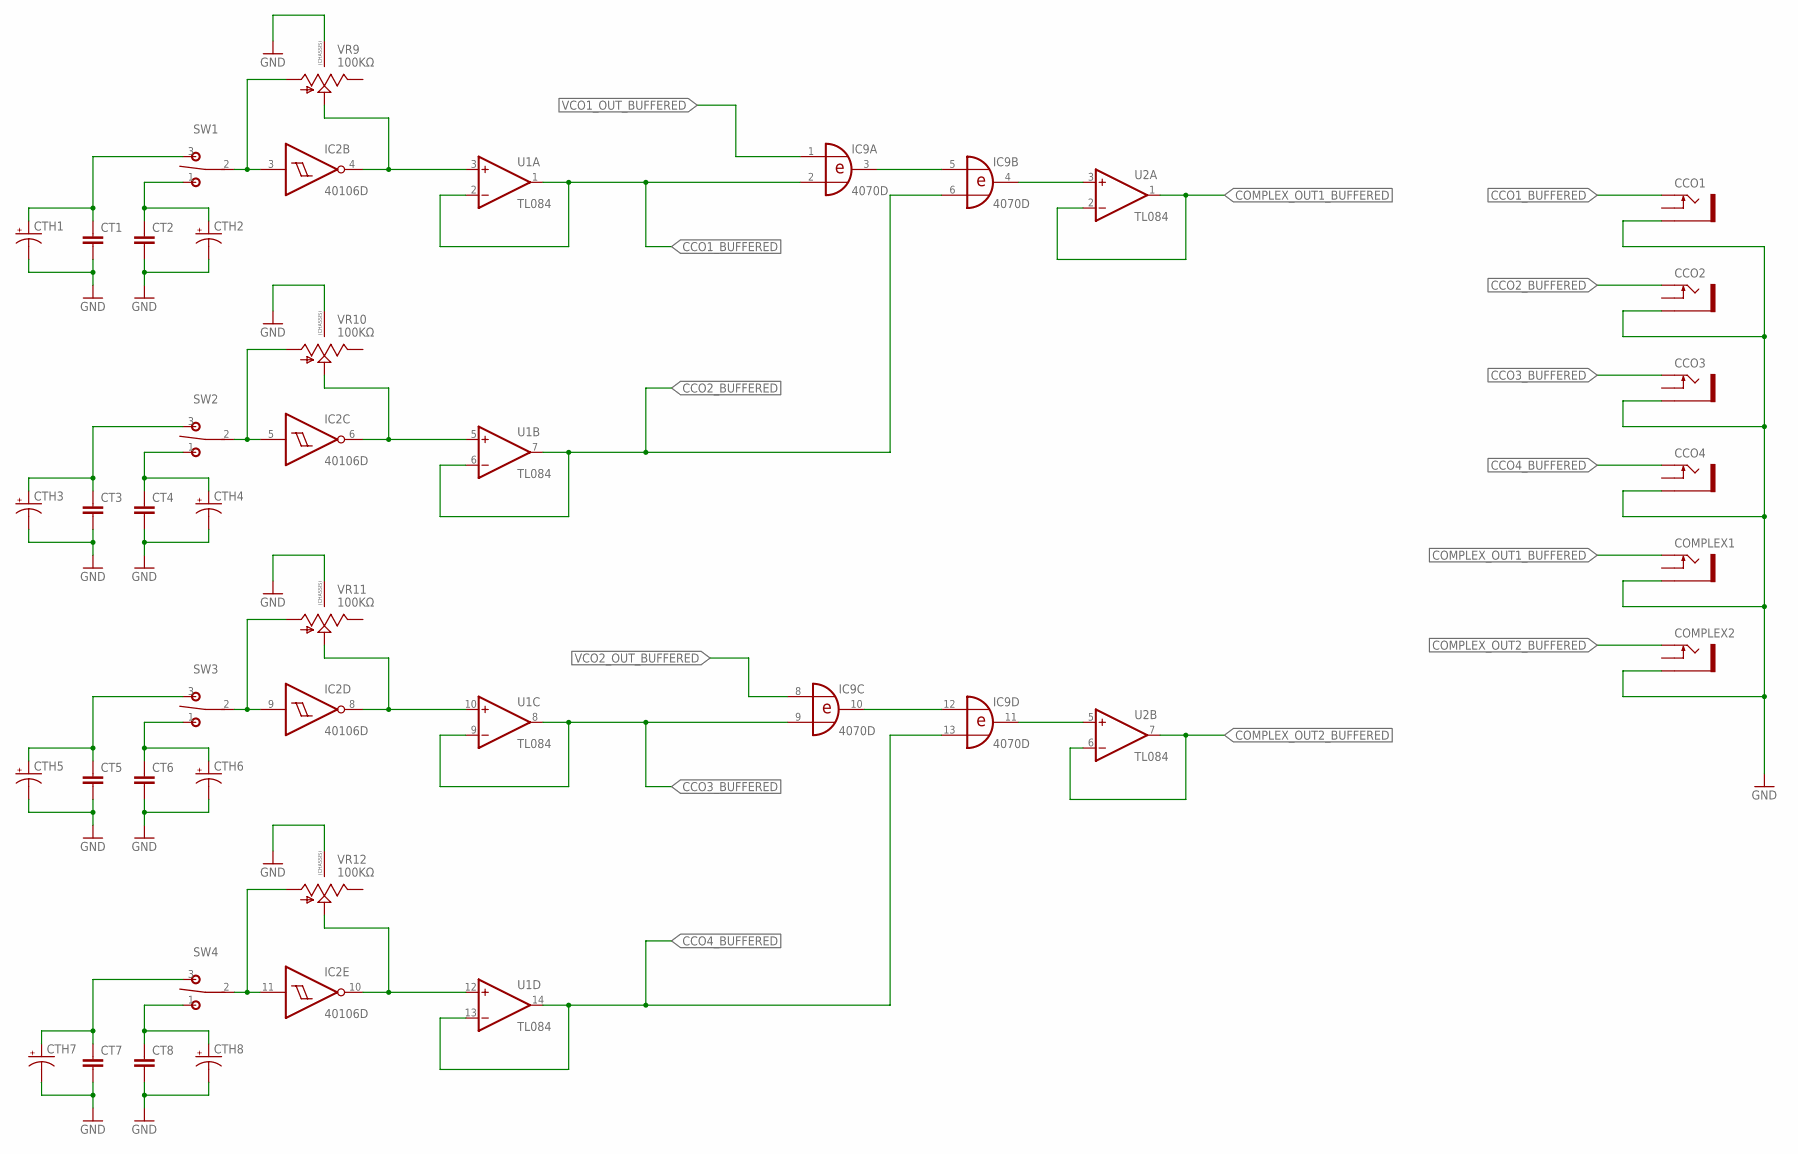
[picture p34: schematic seamonster_buffered3.sch, sheet 4, Fixed Frequency Oscillators]

Parts:
CCO1, CCO2, CCO3, CCO4: THONKICONNNEW; WQP-PJ301M-12_JACK
COMPLEX1, COMPLEX2: THONKICONNNEW; WQP-PJ301M-12_JACK
CT1, CT2, CT3, CT4, CT5, CT6, CT7, CT8: CAP0805; 0805
CTH1, CTH2, CTH3, CTH4, CTH5, CTH6, CTH7, CTH8: CAP_POLPTH2; CPOL-RADIAL-10UF-25V
IC2: 40106D; SO14
IC9: 4070D; SO14
SW1, SW2, SW3, SW4: SPDT ON-ON; M9040P
U1, U2: TL084; SO14
VR9, VR10, VR11, VR12: 100KΩ; 9MM_SNAP-IN_POT

Connections:
CCO1_BUFFERED: CCO1.P$1_TIP (TIP), IC9.2 (I1), U1.1 (OUT), U1.2 (-IN)
CCO2_BUFFERED: CCO2.P$1_TIP (TIP), IC9.6 (I1), U1.6 (-IN), U1.7 (OUT)
CCO3_BUFFERED: CCO3.P$1_TIP (TIP), IC9.9 (I1), U1.8 (OUT), U1.9 (-IN)
CCO4_BUFFERED: CCO4.P$1_TIP (TIP), IC9.13 (I1), U1.13 (-IN), U1.14 (OUT)
COMPLEX_OUT1_BUFFERED: COMPLEX1.P$1_TIP (TIP), U2.1 (OUT), U2.2 (-IN)
COMPLEX_OUT2_BUFFERED: COMPLEX2.P$1_TIP (TIP), U2.6 (-IN), U2.7 (OUT)
GND: CCO1.P$3_SLEEVE (SLEEVE), CCO2.P$3_SLEEVE (SLEEVE), CCO3.P$3_SLEEVE (SLEEVE), CCO4.P$3_SLEEVE (SLEEVE), COMPLEX1.P$3_SLEEVE (SLEEVE), COMPLEX2.P$3_SLEEVE (SLEEVE), CT1.2, CT2.2, CT3.2, CT4.2, CT5.2, CT6.2, CT7.2, CT8.2, CTH1.2 (-), CTH2.2 (-), CTH3.2 (-), CTH4.2 (-), CTH5.2 (-), CTH6.2 (-), CTH7.2 (-), CTH8.2 (-), VR9.CHASSIS2, VR10.CHASSIS2, VR11.CHASSIS2, VR12.CHASSIS2; also elsewhere on the board
INV_B_IN: IC2.3 (I), SW1.2, VR9.1 (A)
INV_B_OUT: IC2.4 (O), U1.3 (+IN), VR9.2 (S)
INV_C_IN: IC2.5 (I), SW2.2, VR10.1 (A)
INV_C_OUT: IC2.6 (O), U1.5 (+IN), VR10.2 (S)
INV_D_IN: IC2.9 (I), SW3.2, VR11.1 (A)
INV_D_OUT: IC2.8 (O), U1.10 (+IN), VR11.2 (S)
INV_E_IN: IC2.11 (I), SW4.2, VR12.1 (A)
INV_E_OUT: IC2.10 (O), U1.12 (+IN), VR12.2 (S)
unnamed: IC9.3 (O), IC9.5 (I0)
unnamed: IC9.10 (O), IC9.12 (I0)
unnamed: IC9.4 (O), U2.3 (+IN)
unnamed: IC9.11 (O), U2.5 (+IN)
unnamed: CT2.1, CTH2.1 (+), SW1.1 (O)
unnamed: CT1.1, CTH1.1 (+), SW1.3 (S)
unnamed: CT4.1, CTH4.1 (+), SW2.1 (O)
unnamed: CT3.1, CTH3.1 (+), SW2.3 (S)
unnamed: CT6.1, CTH6.1 (+), SW3.1 (O)
unnamed: CT5.1, CTH5.1 (+), SW3.3 (S)
unnamed: CT8.1, CTH8.1 (+), SW4.1 (O)
unnamed: CT7.1, CTH7.1 (+), SW4.3 (S)
VCO1_OUT_BUFFERED: IC9.1 (I0); also elsewhere on the board
VCO2_OUT_BUFFERED: IC9.8 (I0); also elsewhere on the board

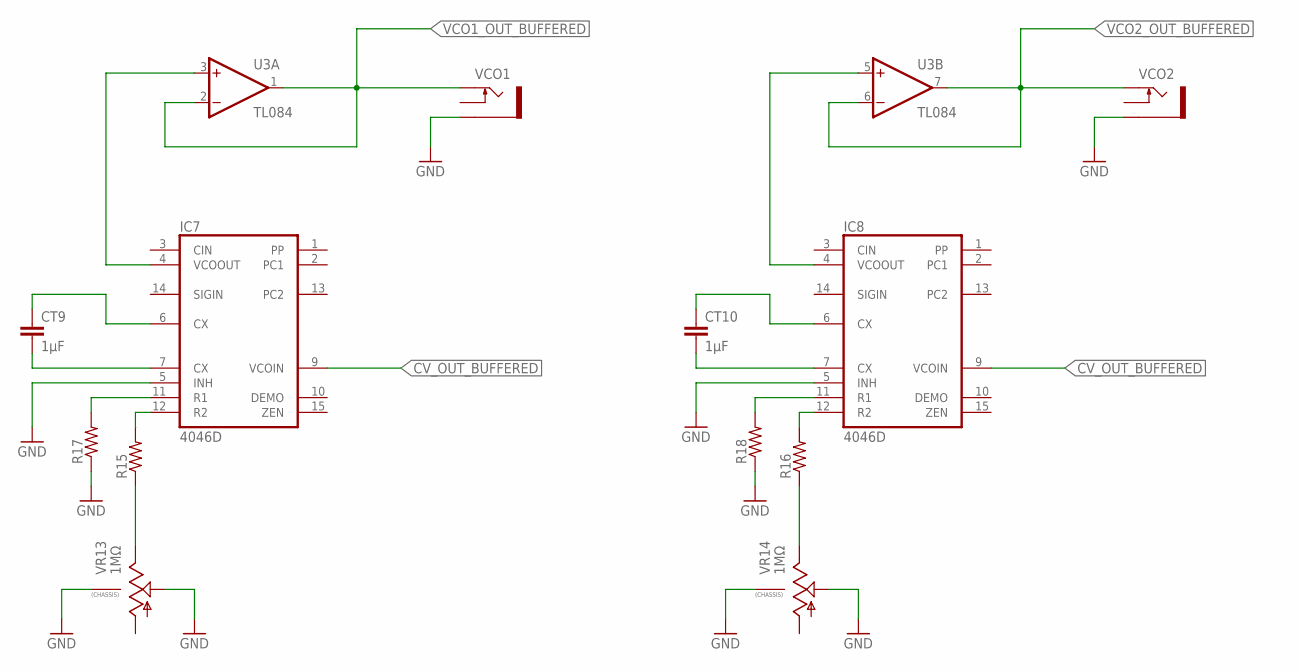
[picture p35: schematic seamonster_buffered3.sch, sheet 5, Voltage Controlled Oscillators]

Parts:
CT9, CT10: 1µF; 0805
IC7, IC8: 4046D; SO16
R15, R16, R17, R18: RESISTOR0805-RES; 0805
U3: TL084; SO14
VCO1, VCO2: THONKICONNNEW; WQP-PJ301M-12_JACK
VR13, VR14: 1MΩ; 9MM_SNAP-IN_POT

Connections:
CV_OUT_BUFFERED: IC7.9 (VCOIN), IC8.9 (VCOIN); also elsewhere on the board
GND: IC7.5 (INH), IC8.5 (INH), R17.1, R18.1, VCO1.P$3_SLEEVE (SLEEVE), VCO2.P$3_SLEEVE (SLEEVE), VR13.2 (S), VR13.CHASSIS2, VR14.2 (S), VR14.CHASSIS2; also elsewhere on the board
unnamed: IC7.12 (R2), R15.2
unnamed: R15.1, VR13.3 (E)
unnamed: CT9.1, IC7.6 (CX)
unnamed: CT9.2, IC7.7 (CX)
unnamed: CT10.1, IC8.6 (CX)
unnamed: CT10.2, IC8.7 (CX)
unnamed: IC8.12 (R2), R16.2
unnamed: R16.1, VR14.3 (E)
unnamed: IC8.11 (R1), R18.2
unnamed: IC7.11 (R1), R17.2
VCO1_OUT: IC7.4 (VCOOUT), U3.3 (+IN)
VCO1_OUT_BUFFERED: U3.1 (OUT), U3.2 (-IN), VCO1.P$1_TIP (TIP); also elsewhere on the board
VCO2_OUT: IC8.4 (VCOOUT), U3.5 (+IN)
VCO2_OUT_BUFFERED: U3.6 (-IN), U3.7 (OUT), VCO2.P$1_TIP (TIP); also elsewhere on the board

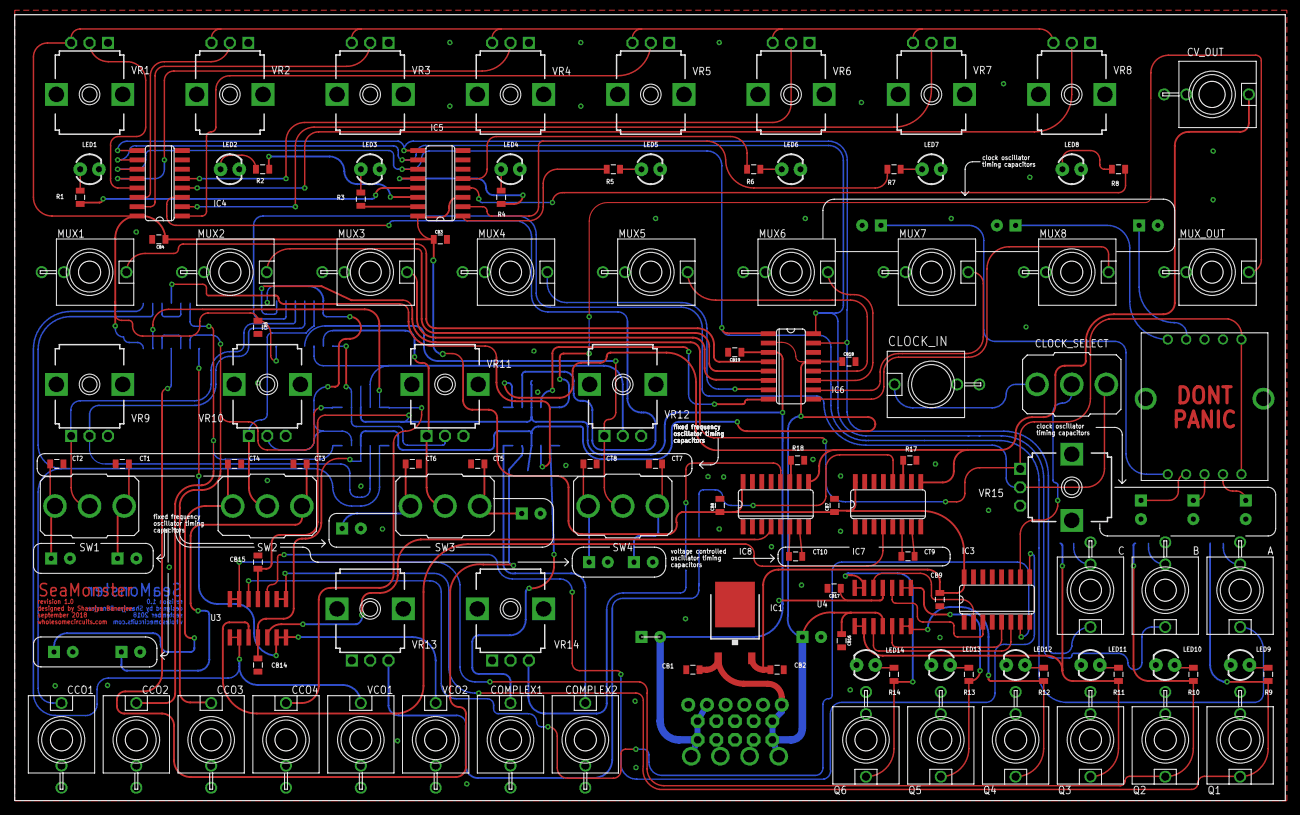
[picture p36: board seamonster_buffered3.brd from above]

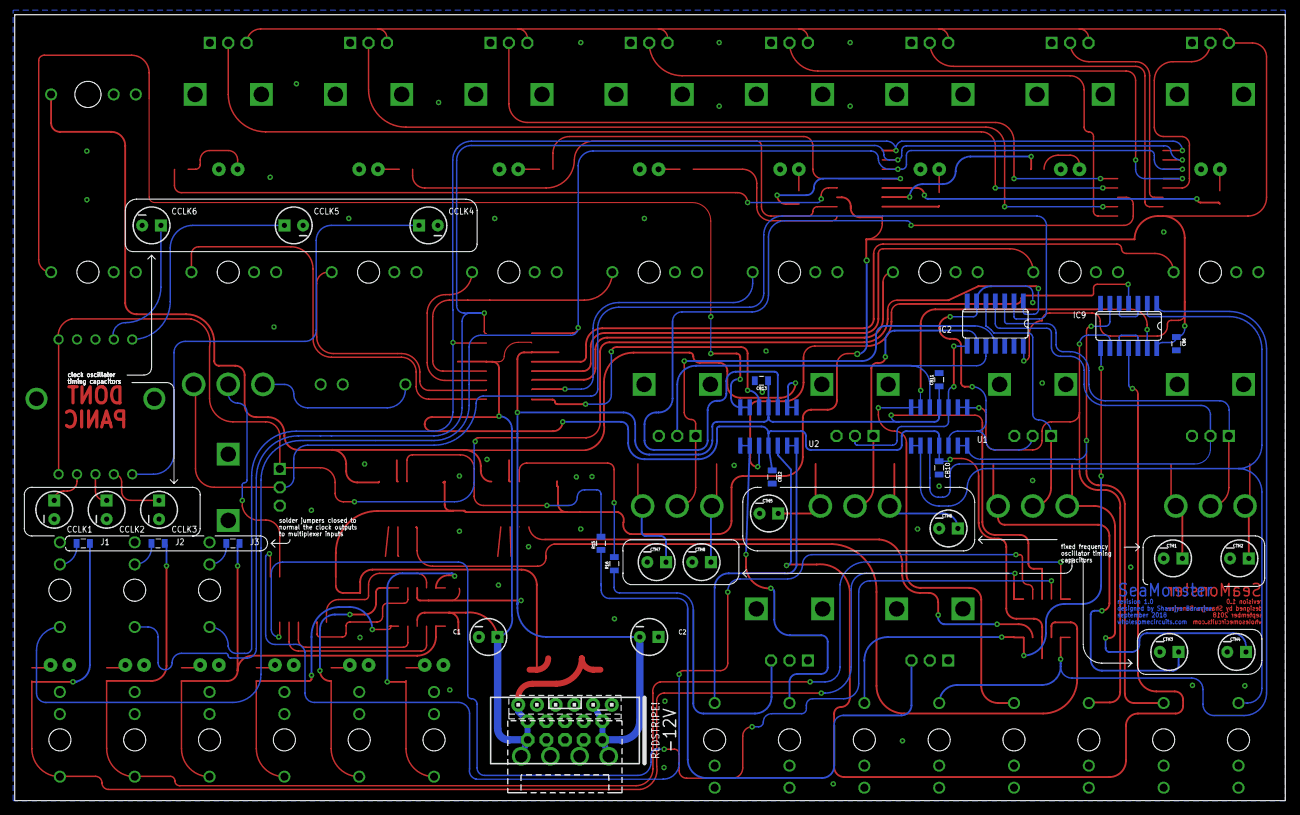
[picture p37: board seamonster_buffered3.brd from below]

Board: 2 copper layers, 172.5 x 106.7 mm, 143 parts (31 on the bottom side), 114 nets.
