shaurjyabanerjee/seamonster/pcb_layouts/seamonster_smd/seamonster_buffered_draft2/seamonster_buffered2.brd

## EAGLE design pcb_layouts/seamonster_smd/seamonster_buffered_draft2/seamonster_buffered2.brd (2018-09-28)

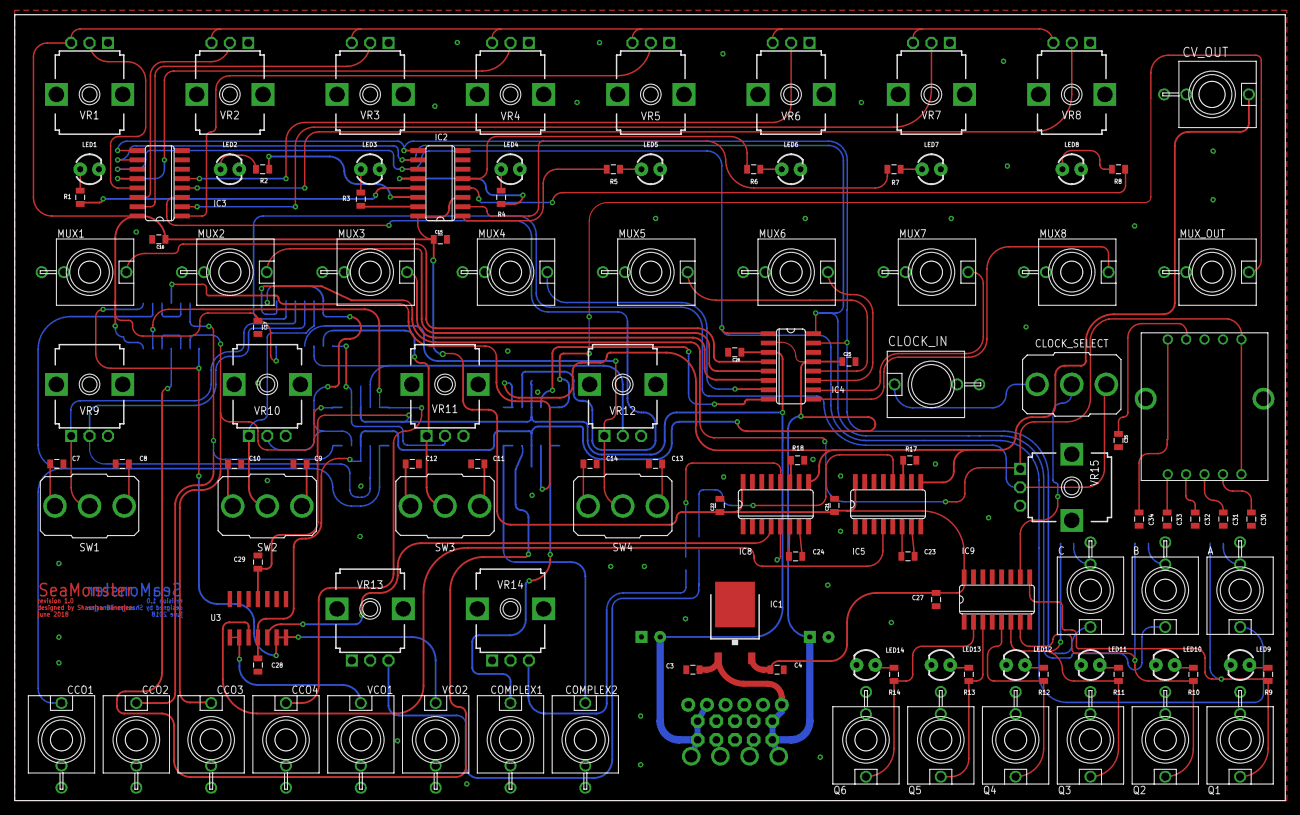
[picture p38: board seamonster_buffered2.brd from above]

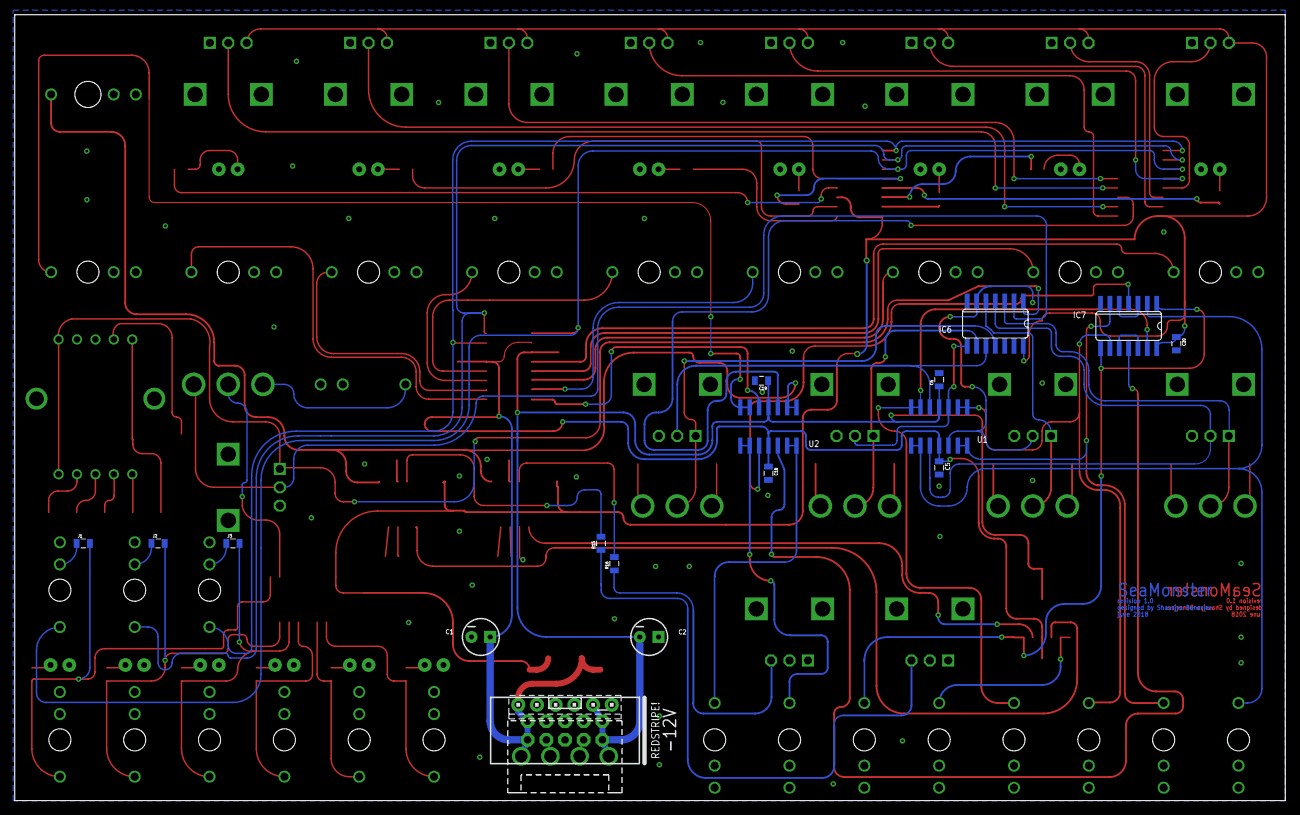
[picture p39: board seamonster_buffered2.brd from below]

Board: 2 copper layers, 172.5 x 106.7 mm, 132 parts (17 on the bottom side), 108 nets.

Parts:
A: THONKICONNNEW; WQP-PJ301M-12_JACK
B: THONKICONNNEW; WQP-PJ301M-12_JACK
C: THONKICONNNEW; WQP-PJ301M-12_JACK
C1, C2: 47µF; CPOL-RADIAL-10UF-25V
C3, C4, C5, C6, C7, C10, C12, C14, C15, C16, C17, C18, C19, C20, C21, C22, C25, C26, C27, C28, C29: 0.1µF; 0805
C8, C9, C11, C13, C23, C24: 1µF; 0805
C30, C31, C32, C33, C34, C35: 0805
CCO1, CCO2, CCO3, CCO4: THONKICONNNEW; WQP-PJ301M-12_JACK
CLOCK_IN: THONKICONNNEW; WQP-PJ301M-12_JACK
CLOCK_SELECT: SPDT ON-ON; M9040P
COMPLEX1, COMPLEX2: THONKICONNNEW; WQP-PJ301M-12_JACK
CV_OUT: THONKICONNNEW; WQP-PJ301M-12_JACK
IC1: 7808DT; TO252
IC2, IC3: 4051D; SO16
IC4: DG408DY; SO16
IC5, IC8: 4046D; SO16
IC6: 40106D; SO14
IC7: 4070D; SO14
IC9: 4040D; SO16
J1, J2, J3: 0805
LED1, LED2, LED3, LED4, LED5, LED6, LED7, LED8, LED9, LED10, LED11, LED12, LED13, LED14: LED3MM
MUX1, MUX2, MUX3, MUX4, MUX5, MUX6, MUX7, MUX8: THONKICONNNEW; WQP-PJ301M-12_JACK
MUX_OUT: THONKICONNNEW; WQP-PJ301M-12_JACK
Q1, Q2, Q3, Q4, Q5, Q6: THONKICONNNEW; WQP-PJ301M-12_JACK
R1, R2, R3, R4, R5, R6, R7, R8, R9, R10, R11, R12, R13, R14, R15, R16, R17, R18: 0805
SW1, SW2, SW3, SW4: SPDT ON-ON; M9040P
U1, U2, U3: TL084; SO14
U$1: COMBO_POWER
U$2: ALPHA_ROTARY_SWITCH; ALPHA_SR1712F
VCO1, VCO2: THONKICONNNEW; WQP-PJ301M-12_JACK
VR1, VR2, VR3, VR4, VR5, VR6, VR7, VR8, VR9, VR10, VR11, VR12, VR15: 100KΩ; 9MM_SNAP-IN_POT
VR13, VR14: 1MΩ; 9MM_SNAP-IN_POT

Connections:
A: A.P$1_TIP, IC2.11, IC3.11, IC4.1
B: B.P$1_TIP, IC2.10, IC3.10, IC4.16
C: C.P$1_TIP, IC2.9, IC3.9, IC4.15
CCO1_BUFFERED: CCO1.P$1_TIP, IC7.2, U1.1, U1.2
CCO2_BUFFERED: CCO2.P$1_TIP, IC7.6, U1.6, U1.7
CCO3_BUFFERED: CCO3.P$1_TIP, IC7.9, U1.8, U1.9
CCO4_BUFFERED: CCO4.P$1_TIP, IC7.13, U1.13, U1.14
COMPLEX_OUT1_BUFFERED: COMPLEX1.P$1_TIP, U2.1, U2.2
COMPLEX_OUT2_BUFFERED: COMPLEX2.P$1_TIP, U2.6, U2.7
CV_OUT: IC3.3, U2.10
CV_OUT_BUFFERED: CV_OUT.P$1_TIP, IC5.9, IC8.9, U2.8, U2.9
GND: A.P$3_SLEEVE, B.P$3_SLEEVE, C.P$3_SLEEVE, C1.2, C2.1, C3.2, C4.2, C5.2, C6.2, C7.2, C8.2, C9.2, C10.2, C11.2, C12.2, C13.2, C14.2, C15.2, C16.2, C17.2, C18.2, C19.2, C20.2, C21.2, C22.2, C25.2, C26.2, C27.2, C28.2, C29.2, C30.2, C31.2, C32.2, C33.2, C34.2, C35.2, CCO1.P$3_SLEEVE, CCO2.P$3_SLEEVE, CCO3.P$3_SLEEVE, CCO4.P$3_SLEEVE, CLOCK_IN.P$3_SLEEVE, COMPLEX1.P$3_SLEEVE, COMPLEX2.P$3_SLEEVE, CV_OUT.P$3_SLEEVE, IC1.3, IC2.6, IC2.7, IC2.8, IC3.6, IC3.7, IC3.8, IC4.14, IC5.5, IC5.8, IC6.7, IC7.7, IC8.5, IC8.8, IC9.8, IC9.11, LED1.K, LED2.K, LED3.K, LED4.K, LED5.K, LED6.K, LED7.K, LED8.K, LED9.K, LED10.K, LED11.K, LED12.K, LED13.K, LED14.K, MUX1.P$3_SLEEVE, MUX2.P$3_SLEEVE, MUX3.P$3_SLEEVE, MUX4.P$3_SLEEVE, MUX5.P$3_SLEEVE, MUX6.P$3_SLEEVE, MUX7.P$3_SLEEVE, MUX8.P$3_SLEEVE, MUX_OUT.P$3_SLEEVE, Q1.P$3_SLEEVE, Q2.P$3_SLEEVE, Q3.P$3_SLEEVE, Q4.P$3_SLEEVE, Q5.P$3_SLEEVE, Q6.P$3_SLEEVE, R17.1, R18.1, U$1.COM-DOTCOM, U$1.COM-EURO1, U$1.COM-EURO2, U$1.COM-EURO3, U$1.COM-EURO4, U$1.COM-EURO5, U$1.COM-EURO6, U$1.COM-MOTM1, U$1.COM_MOTM2, VCO1.P$3_SLEEVE, VCO2.P$3_SLEEVE, VR1.1, VR1.CHASSIS2, VR2.1, VR2.CHASSIS2, VR3.1, VR3.CHASSIS2, VR4.1, VR4.CHASSIS2, VR5.1, VR5.CHASSIS2, VR6.1, VR6.CHASSIS2, VR7.1, VR7.CHASSIS2, VR8.1, VR8.CHASSIS2, VR9.CHASSIS2, VR10.CHASSIS2, VR11.CHASSIS2, VR12.CHASSIS2, VR13.2, VR13.CHASSIS2, VR14.2, VR14.CHASSIS2, VR15.CHASSIS2
INV_B_IN: IC6.3, SW1.2, VR9.1
INV_B_OUT: IC6.4, U1.3, VR9.2
INV_C_IN: IC6.5, SW2.2, VR10.1
INV_C_OUT: IC6.6, U1.5, VR10.2
INV_D_IN: IC6.9, SW3.2, VR11.1
INV_D_OUT: IC6.8, U1.10, VR11.2
INV_E_IN: IC6.11, SW4.2, VR12.1
INV_E_OUT: IC6.10, U1.12, VR12.2
MUX1: IC4.4, MUX1.P$1_TIP
MUX2: IC4.5, MUX2.P$1_TIP
MUX3: IC4.6, MUX3.P$1_TIP
MUX4: IC4.7, MUX4.P$1_TIP
MUX5: IC4.12, MUX5.P$1_TIP
MUX6: IC4.11, MUX6.P$1_TIP
MUX7: IC4.10, MUX7.P$1_TIP
MUX8: IC4.9, MUX8.P$1_TIP
unnamed: IC4.8, U2.12
unnamed: IC6.1, U$2.1, U$2.10, VR15.1
unnamed: C30.1, U$2.2
unnamed: C31.1, U$2.3
unnamed: C32.1, U$2.4
unnamed: C33.1, U$2.5
unnamed: C34.1, U$2.6
unnamed: C35.1, U$2.7
unnamed: MUX_OUT.P$1_TIP, U2.13, U2.14
unnamed: LED1.A, R1.2
unnamed: LED2.A, R2.2
unnamed: LED3.A, R3.2
unnamed: LED4.A, R4.2
unnamed: LED5.A, R5.2
unnamed: LED6.A, R6.2
unnamed: LED7.A, R7.2
unnamed: LED8.A, R8.2
unnamed: IC3.13, VR1.2
unnamed: IC2.13, R1.1
unnamed: IC2.14, R2.1
unnamed: IC2.15, R3.1
unnamed: IC2.12, R4.1
unnamed: IC2.1, R5.1
unnamed: IC2.5, R6.1
unnamed: IC2.2, R7.1
unnamed: IC2.4, R8.1
unnamed: IC3.14, VR2.2
unnamed: IC3.15, VR3.2
unnamed: IC3.12, VR4.2
unnamed: IC3.1, VR5.2
unnamed: IC3.5, VR6.2
unnamed: IC3.2, VR7.2
unnamed: IC3.4, VR8.2
unnamed: A.P$2_SWITCH, J1.1
unnamed: IC7.3, IC7.5
unnamed: IC7.10, IC7.12
unnamed: B.P$2_SWITCH, J2.1
unnamed: IC7.4, U2.3
unnamed: IC7.11, U2.5
unnamed: IC5.12, R15.2
unnamed: R15.1, VR13.3
unnamed: CLOCK_SELECT.3, IC6.2, VR15.2
unnamed: C23.1, IC5.6
unnamed: C23.2, IC5.7
unnamed: C7.1, SW1.1
unnamed: C24.1, IC8.6
unnamed: C24.2, IC8.7
unnamed: CLOCK_SELECT.2, IC9.10
unnamed: LED9.A, R9.2
unnamed: C8.1, SW1.3
unnamed: C10.1, SW2.1
unnamed: C9.1, SW2.3
unnamed: C12.1, SW3.1
unnamed: C11.1, SW3.3
unnamed: C14.1, SW4.1
unnamed: C13.1, SW4.3
unnamed: LED10.A, R10.2
unnamed: LED11.A, R11.2
unnamed: LED12.A, R12.2
unnamed: LED13.A, R13.2
unnamed: LED14.A, R14.2
unnamed: CLOCK_IN.P$1_TIP, CLOCK_SELECT.1
unnamed: IC8.12, R16.2
unnamed: R16.1, VR14.3
unnamed: IC8.11, R18.2
unnamed: IC5.11, R17.2
unnamed: C.P$2_SWITCH, J3.1
Q1: IC9.9, J1.2, Q1.P$1_TIP, R9.1
Q2: IC9.7, J2.2, Q2.P$1_TIP, R10.1
Q3: IC9.6, J3.2, Q3.P$1_TIP, R11.1
Q4: IC9.5, Q4.P$1_TIP, R12.1
Q5: IC9.3, Q5.P$1_TIP, R13.1
Q6: IC9.2, Q6.P$1_TIP, R14.1
V+: C1.1, C3.1, C5.1, C18.1, C25.1, C28.1, IC1.1, IC4.2, IC4.13, U1.4, U2.4, U3.4, U$1.V+DOTCOM, U$1.V+EURO1, U$1.V+EURO2, U$1.V+MOTM
V-: C2.2, C6.1, C19.1, C26.1, C29.1, IC4.3, U1.11, U2.11, U3.11, U$1.V-DOTCOM, U$1.V-EURO1, U$1.V-EURO2, U$1.V-MOTM
VCC: C4.1, C15.1, C16.1, C17.1, C20.1, C21.1, C22.1, C27.1, IC1.2, IC2.3, IC2.16, IC3.16, IC5.16, IC6.14, IC7.14, IC8.16, IC9.16, VR1.3, VR2.3, VR3.3, VR4.3, VR5.3, VR6.3, VR7.3, VR8.3
VCO1_OUT: IC5.4, U3.3
VCO1_OUT_BUFFERED: U3.1, U3.2, VCO1.P$1_TIP
VCO2_OUT: IC8.4, U3.5
VCO2_OUT_BUFFERED: IC7.1, IC7.8, U3.6, U3.7, VCO2.P$1_TIP
