shaurjyabanerjee/seamonster/(commit log)

2017-07-05 inital commit
    [seamonster_drill.dwg, seamonster_drill.dxf, seamonster_smd_draft1.brd, seamonster_smd_draft1.sch]
2017-07-10 added new panel drill files for prototype panel
    [seamonster_smd_draft1.brd, seamonster_smd_draft1.sch]
2017-07-11 made new folder for buffered seamonster
    [seamonster_buffered1.brd, seamonster_buffered1.sch]
2017-07-11 figured out invoking across multiple sheets
    [seamonster_buffered1.brd, seamonster_buffered1.sch]
2017-07-12 fleshed out schematic pages
    [seamonster_buffered1.brd, seamonster_buffered1.sch]
2017-07-13 added in VCOs and more buffering
    [seamonster_buffered1.brd, seamonster_buffered1.sch]
2017-07-13 roughly positioned thruhole panel parts
    [seamonster_buffered1.brd, seamonster_buffered1.sch]
2017-07-14 roughly placed all remaining parts
    [seamonster_buffered1.brd, seamonster_buffered1.sch]
2017-07-14 added top and bottom layer ground pours, did basic layout
    [seamonster_buffered1.brd]
2017-07-14 routed ABC bus between 4051s, more basic routing
    [seamonster_buffered1.brd, seamonster_buffered1.sch]
2017-07-16 made folder for panel files, created pours and dimension layer
    [seamonster_panel_v1.brd, seamonster_panel_v1.sch]
2017-07-16 added drill positions to panel for pots, mux and outs
    [seamonster_panel_v1.brd]
2017-07-17 added jumpers for normalled ABC bus operation
    [seamonster_buffered1.brd, seamonster_buffered1.sch]
2017-07-17 created v2 buffered board, moved ICs
    [seamonster_buffered2.brd, seamonster_buffered2.sch]
2017-07-17 made and custom part for 8 way Alpha rotary switch as clock speed selector
    [seamonster_buffered2.brd]
2017-07-17 routed power nets, moved ICs
    [seamonster_buffered2.brd]
2017-07-18 routed 408 MUX power and most IO
    [seamonster_buffered2.brd]
2017-07-18 finished routing IO to DG408 MUX
    [seamonster_buffered2.brd, seamonster_buffered2.sch]
2017-07-18 cleaned up silkscreen
    [seamonster_buffered2.brd]
2017-07-18 finished routing ABC bus to jacks, began routing oscillators
    [seamonster_buffered2.brd]
2017-07-18 misc routing for oscillators and buffers
    [seamonster_buffered2.brd]
2017-07-20 routed bipolar power to buffers, and buffered cv out
    [seamonster_buffered2.brd]
2017-07-20 more misc buffer and XOR routing
    [seamonster_buffered2.brd]
2017-07-20 connected power nets up, moved and routed VCOs
    [seamonster_buffered2.brd]
2017-07-23 added to-do text file for PCB revisions
    [seamonster_buffered2.brd, seamonster_buffered2.sch]
2018-09-28 finished routing, working on silkscreen
    [seamonster_buffered2.brd, seamonster_buffered3.brd, seamonster_buffered3.sch, seamonster_schematic.sch]
2018-10-15 worked on ai panel mockup, added TH capacitor optionally
    [seamonster_buffered3.brd, seamonster_buffered3.sch, seamonster_panel_backup.brd, seamonster_panel_backup.sch, seamonster_panel_positions.brd, seamonster_panel_positions.sch, wave_test1.dxf]
2019-03-12 smd mk1 routing complete
    [seamonster_buffered3.brd, seamonster_buffered3.sch, seamonster_panel_layout_2.dxf, seamonster_panel_v2.brd, seamonster_panel_v2.sch, waves_simp_test1.dxf]
